mdr32/Boards/LDM-BB-K1986BE92QI-V1.03/README.md

# [LDM-BB-K1986BE92QI](https://ldm-systems.ru/product/19025) - Отладочная плата

Отладочная плата на микроконтроллере [K1986BE92QI](https://ic.milandr.ru/products/mikrokontrollery_i_protsessory/32_razryadnye_mikrokontrollery/k1986ve92qi) от компании [Milandr](https://milandr.ru/)
