mdr32/Boards/LDM-BB-K1986BE92QI-V1.03/img/LDM-BB-K1986BE92QI.png

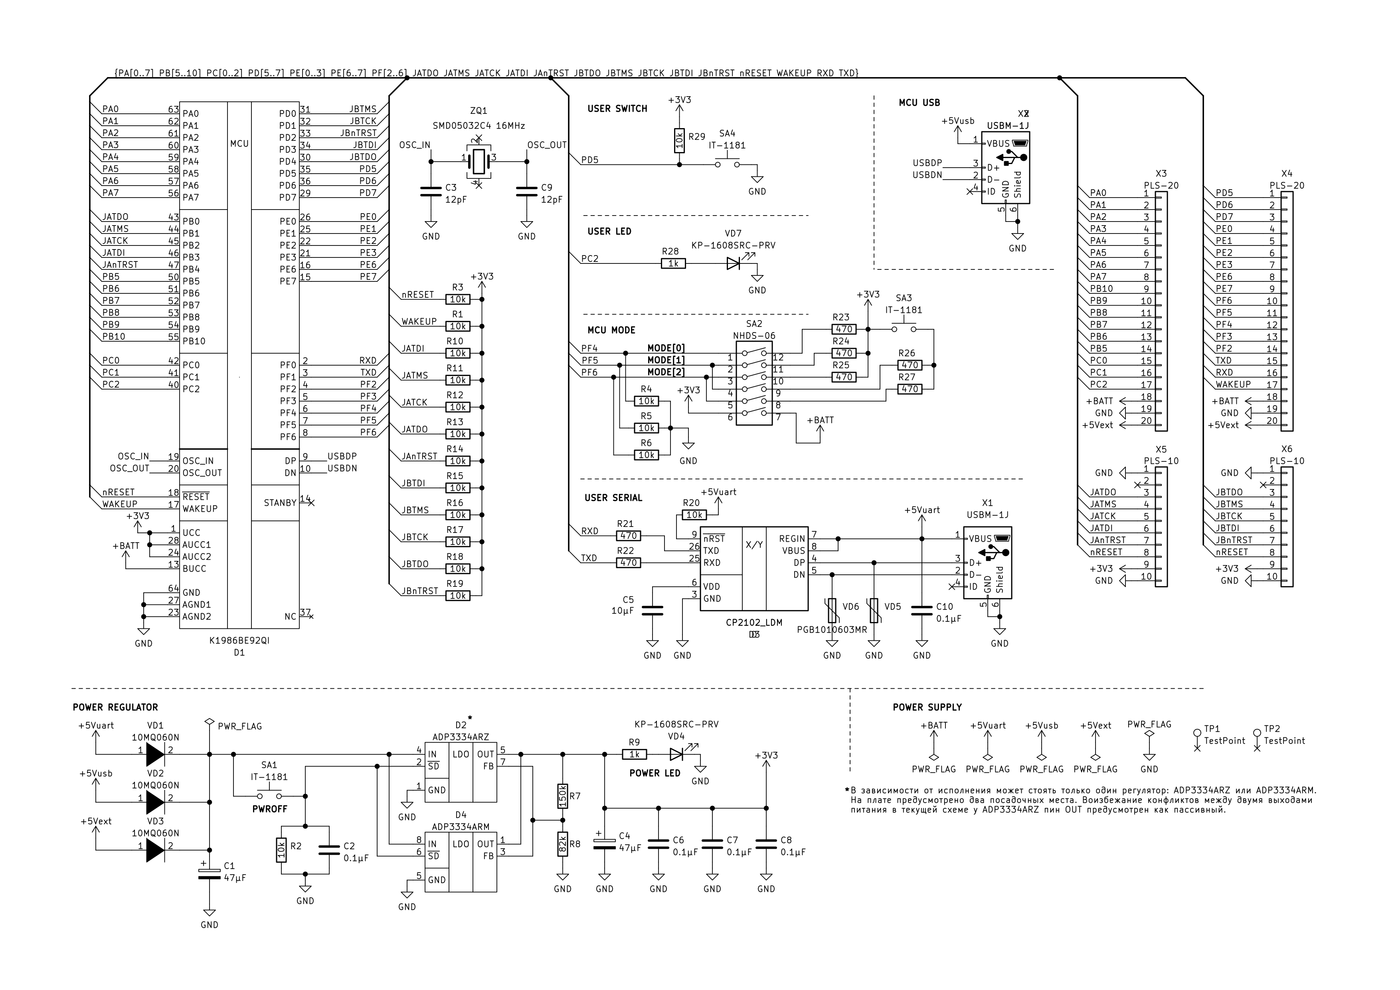
LDM-BB-K1986BE92QI-V1.03/img/LDM-BB-K1986BE92QI.png
