mdr32/Boards/LDM-BB-K1986BE92QI-V1.03/kicad_src/3dmodels/SW_SPST_CK_RS282G05A3.step

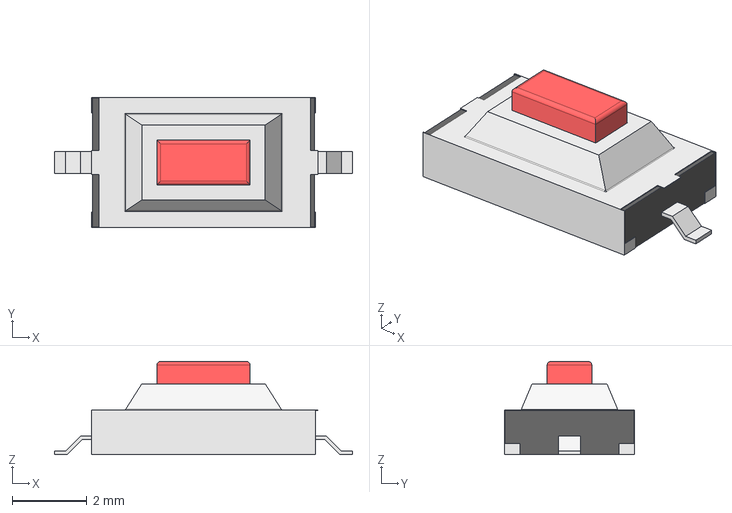
[picture p15: CAD file, 2022-06-08]
LDM-BB-K1986BE92QI-V1.03/kicad_src/3dmodels/SW_SPST_CK_RS282G05A3.step
8.00 x 3.50 x 2.50 mm
