mdr32/Boards/MDR32-K1986BE92FI-DK/kicad_src/3dmodels/LED_0805_2012Metric.step

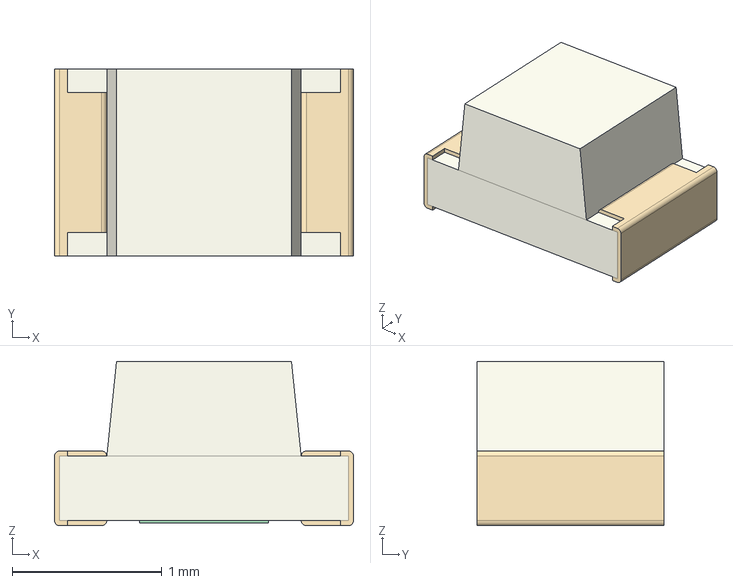
[picture p16: CAD file, 2025-02-06]
MDR32-K1986BE92FI-DK/kicad_src/3dmodels/LED_0805_2012Metric.step
2.00 x 1.25 x 1.10 mm
