mdr32/Boards/LDM-BB-K1986BE92QI-V1.03/kicad_src/3dmodels/LED_0603_1608Metric.step

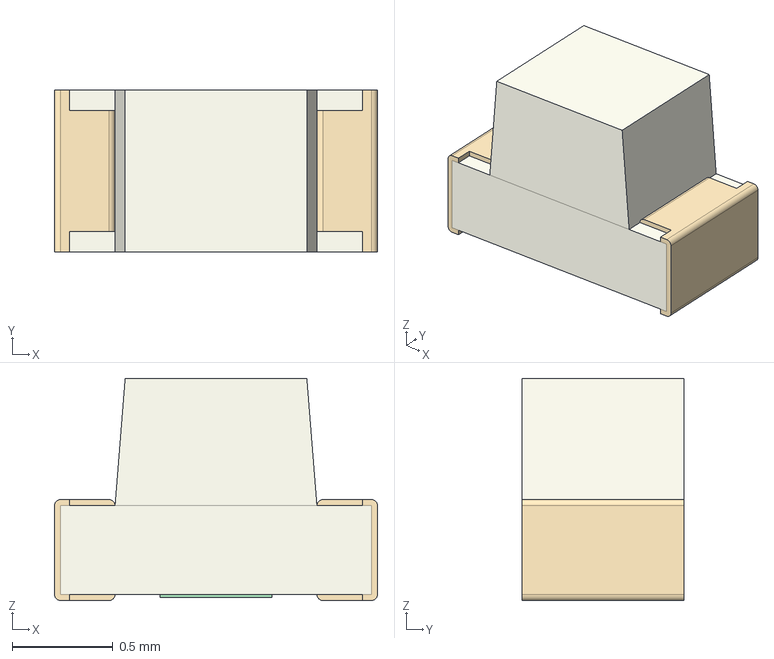
[picture p17: CAD file, 2022-06-08]
LDM-BB-K1986BE92QI-V1.03/kicad_src/3dmodels/LED_0603_1608Metric.step
1.60 x 0.8 x 1.10 mm
