mdr32/Boards/MDR32-K1986BE92FI-DK/kicad_src/3dmodels/Crystal_SMD_3225-4Pin_3.2x2.5mm.step

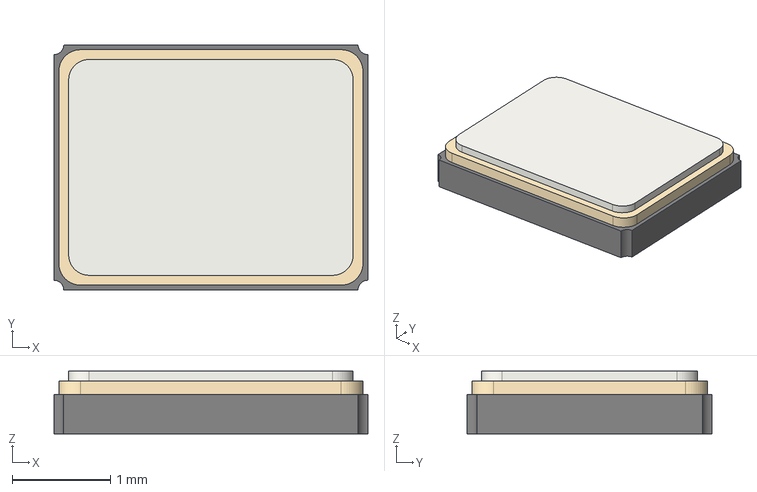
[picture p18: CAD file, 2025-02-06]
MDR32-K1986BE92FI-DK/kicad_src/3dmodels/Crystal_SMD_3225-4Pin_3.2x2.5mm.step
3.20 x 2.50 x 0.64 mm
