mdr32/Boards/LDM-BB-K1986BE92QI-V1.03/kicad_src/3dmodels/C_1206_3216Metric.step

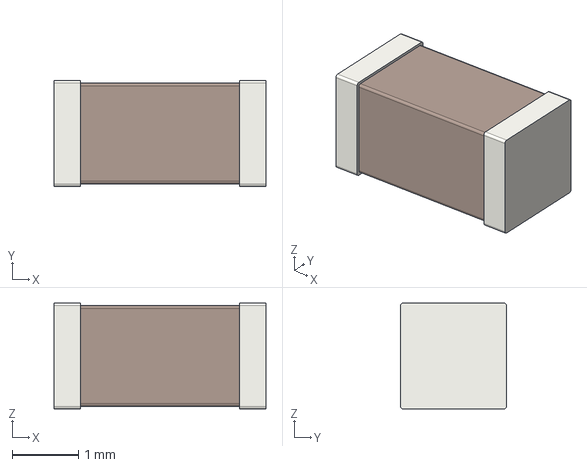
[picture p19: CAD file, 2022-06-08]
LDM-BB-K1986BE92QI-V1.03/kicad_src/3dmodels/C_1206_3216Metric.step
3.20 x 1.60 x 1.60 mm
