mdr32/Boards/MDR32-K1986BE92FI-DK/kicad_src/3dmodels/SOT-23.step

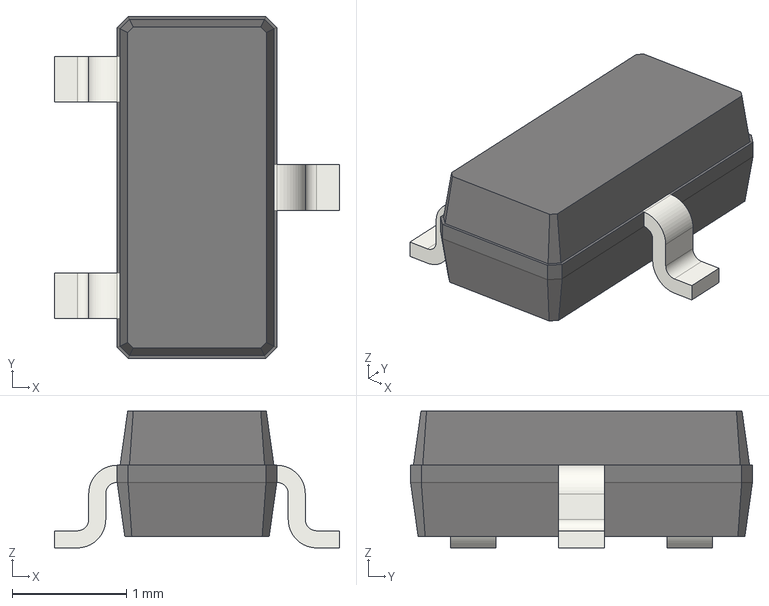
[picture p20: CAD file, 2025-02-06]
MDR32-K1986BE92FI-DK/kicad_src/3dmodels/SOT-23.step
2.50 x 3.00 x 1.20 mm
