mdr32/Boards/LDM-BB-K1986BE92QI-V1.03/kicad_src/3dmodels/R_0805_2012Metric.step

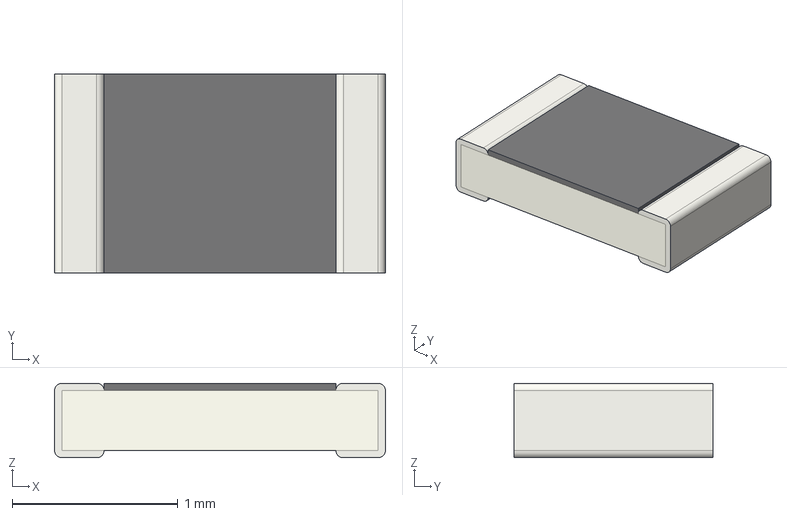
[picture p21: CAD file, 2022-06-08]
LDM-BB-K1986BE92QI-V1.03/kicad_src/3dmodels/R_0805_2012Metric.step
2.00 x 1.20 x 0.45 mm
