mdr32/Boards/MDR32-K1986BE92FI-DK/kicad_src/3dmodels/SOT-223.step

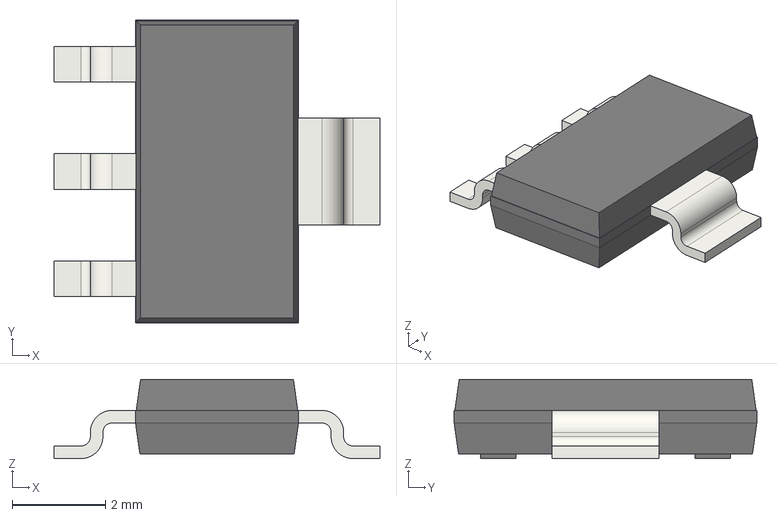
[picture p22: CAD file, 2025-02-06]
MDR32-K1986BE92FI-DK/kicad_src/3dmodels/SOT-223.step
7.00 x 6.50 x 1.70 mm
