mdr32/Boards/LDM-BB-K1986BE92QI-V1.03/kicad_src/3dmodels/DO-214AC.step

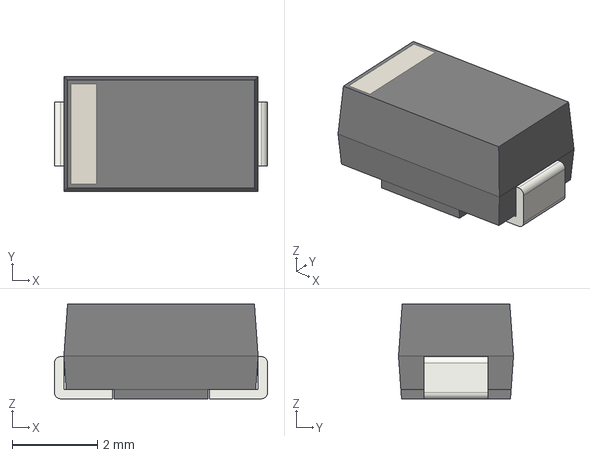
[picture p23: CAD file, 2022-06-08]
LDM-BB-K1986BE92QI-V1.03/kicad_src/3dmodels/DO-214AC.step
5.00 x 2.70 x 2.22 mm
