mdr32/Boards/MDR32-K1986BE92FI-DK/kicad_src/3dmodels/PinHeader_1x04_P2.54mm_Horizontal.step

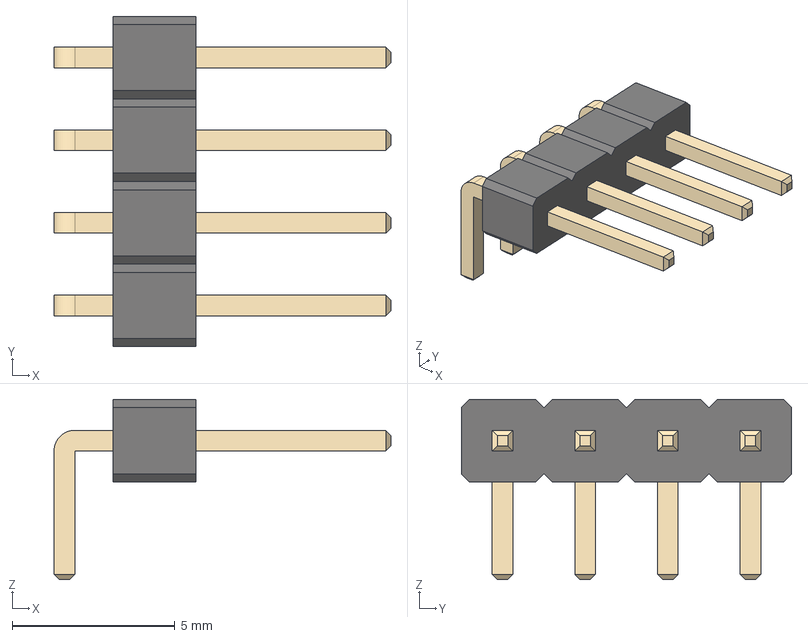
[picture p24: CAD file, 2025-02-06]
MDR32-K1986BE92FI-DK/kicad_src/3dmodels/PinHeader_1x04_P2.54mm_Horizontal.step
10.4 x 10.2 x 5.54 mm
