mdr32/Boards/LDM-BB-K1986BE92QI-V1.03/kicad_src/3dmodels/LQFP-64_10x10mm_P0.5mm.step

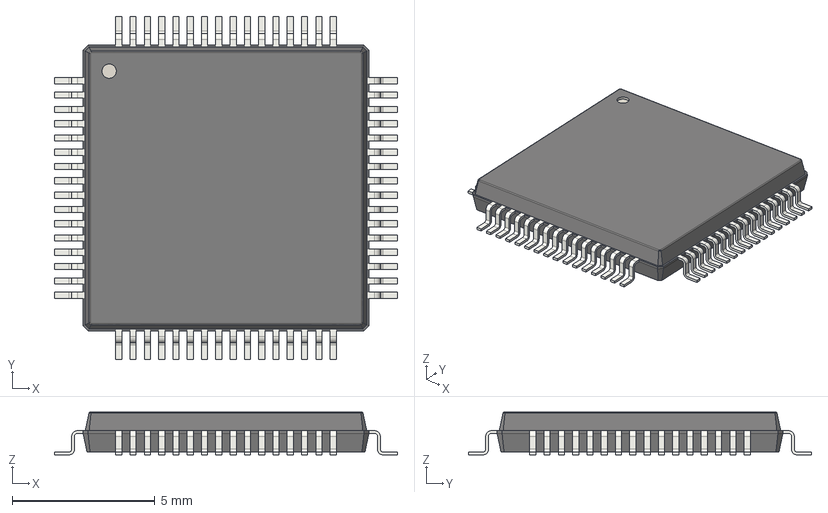
[picture p25: CAD file, 2022-06-08]
LDM-BB-K1986BE92QI-V1.03/kicad_src/3dmodels/LQFP-64_10x10mm_P0.5mm.step
12.0 x 12.0 x 1.50 mm
