mdr32/Boards/MDR32-K1986BE92FI-DK/kicad_src/3dmodels/QFN-64-1EP_9x9mm_P0.5mm_EP7.5x7.5mm.step

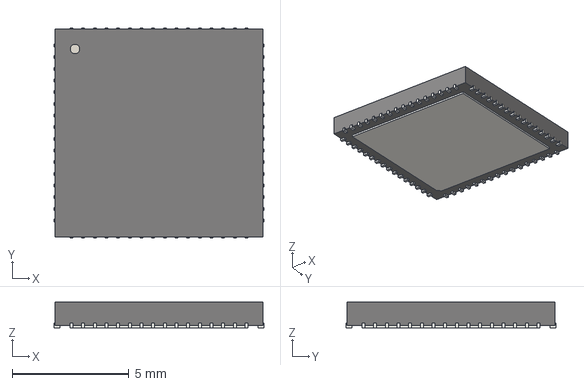
[picture p26: CAD file, 2025-02-06]
MDR32-K1986BE92FI-DK/kicad_src/3dmodels/QFN-64-1EP_9x9mm_P0.5mm_EP7.5x7.5mm.step
9.00 x 9.00 x 1.10 mm
