mdr32/Boards/LDM-BB-K1986BE92QI-V1.03/kicad_src/3dmodels/MSOP-8_3x3mm_P0.65mm.step

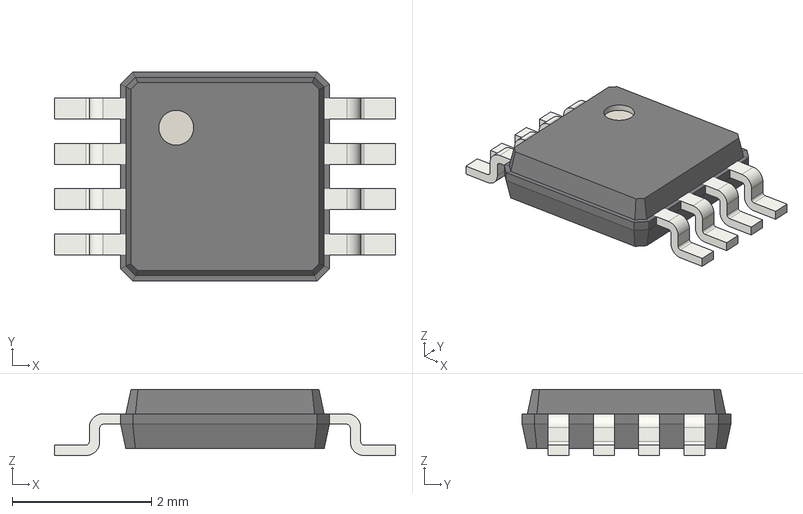
[picture p27: CAD file, 2022-06-08]
LDM-BB-K1986BE92QI-V1.03/kicad_src/3dmodels/MSOP-8_3x3mm_P0.65mm.step
4.90 x 3.00 x 0.95 mm
