mdr32/Boards/MDR32-K1986BE92FI-DK/kicad_src/3dmodels/USB_C_Receptacle_GCT_USB4105-xx-A_16P_TopMnt_Horizontal.step

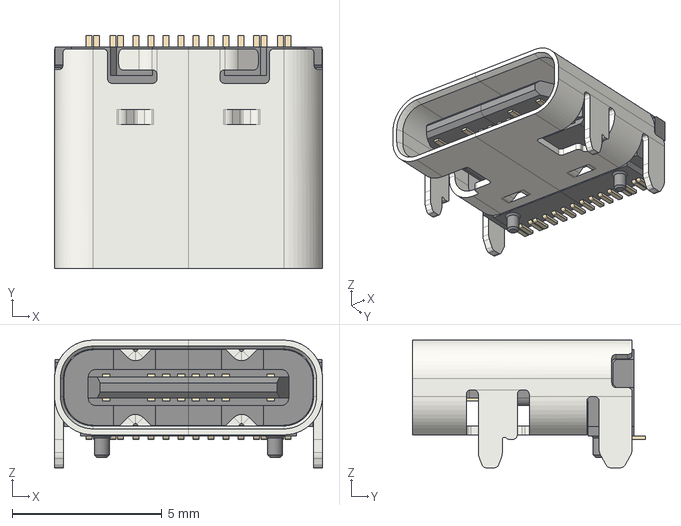
[picture p28: CAD file, 2025-02-06]
MDR32-K1986BE92FI-DK/kicad_src/3dmodels/USB_C_Receptacle_GCT_USB4105-xx-A_16P_TopMnt_Horizontal.step
8.94 x 7.78 x 4.26 mm
