mdr32/Boards/LDM-BB-K1986BE92QI-V1.03/kicad_src/3dmodels/5032_XTAL.step

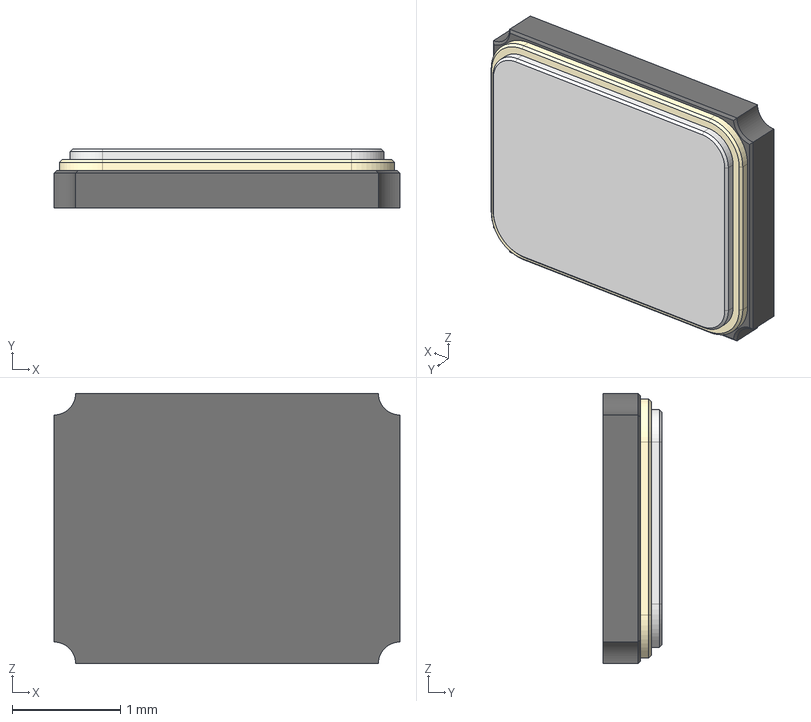
[picture p29: CAD file, 2022-06-08]
LDM-BB-K1986BE92QI-V1.03/kicad_src/3dmodels/5032_XTAL.step
3.20 x 0.55 x 2.50 mm
