mdr32/Boards/MDR32-K1986BE92FI-DK/kicad_src/3dmodels/PinHeader_1x16_P2.54mm_Vertical.step

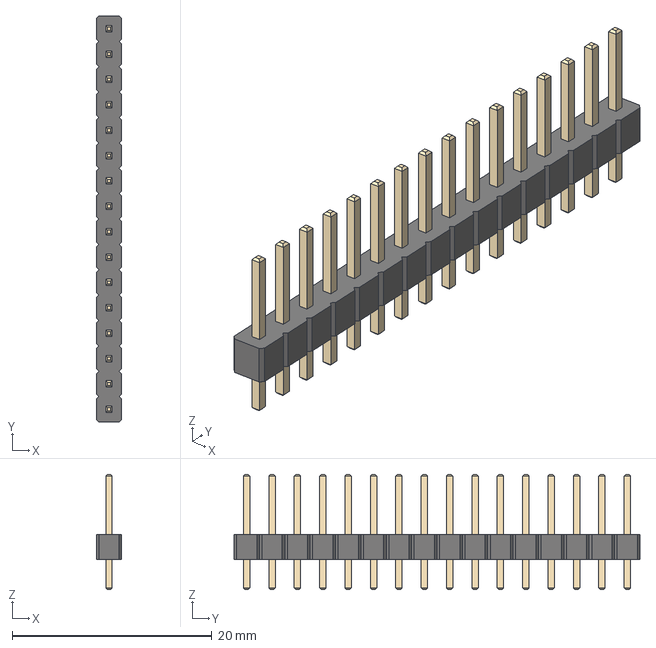
[picture p30: CAD file, 2025-02-06]
MDR32-K1986BE92FI-DK/kicad_src/3dmodels/PinHeader_1x16_P2.54mm_Vertical.step
2.54 x 40.6 x 11.5 mm
