mdr32/Boards/LDM-BB-K1986BE92QI-V1.03/kicad_src/3dmodels/CP_EIA-3528-21_Kemet-B.step

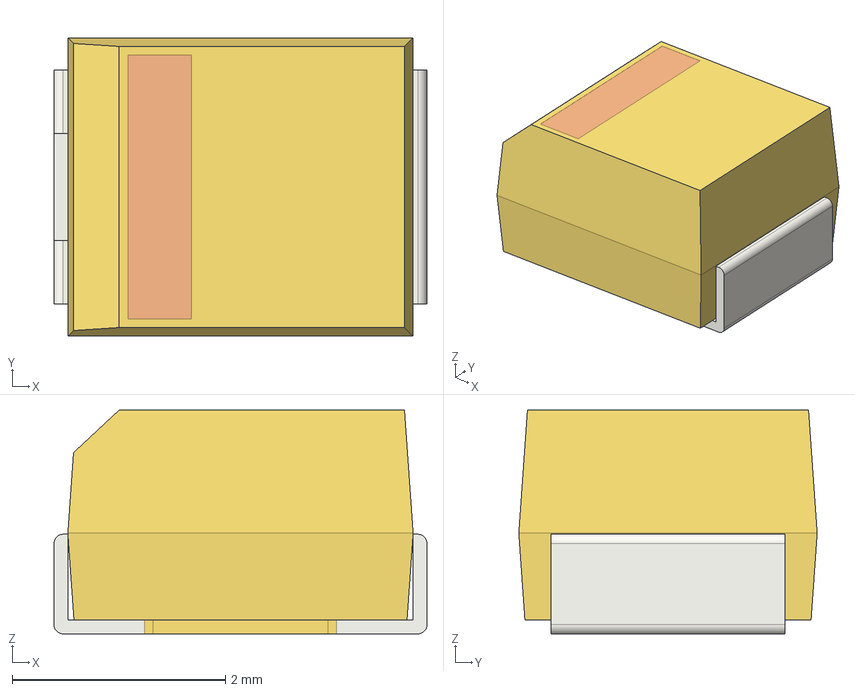
[picture p31: CAD file, 2022-06-08]
LDM-BB-K1986BE92QI-V1.03/kicad_src/3dmodels/CP_EIA-3528-21_Kemet-B.step
3.50 x 2.80 x 2.10 mm
