mdr32/Boards/MDR32-K1986BE92FI-DK/kicad_src/3dmodels/CP_EIA-3216-18_Kemet-A.step

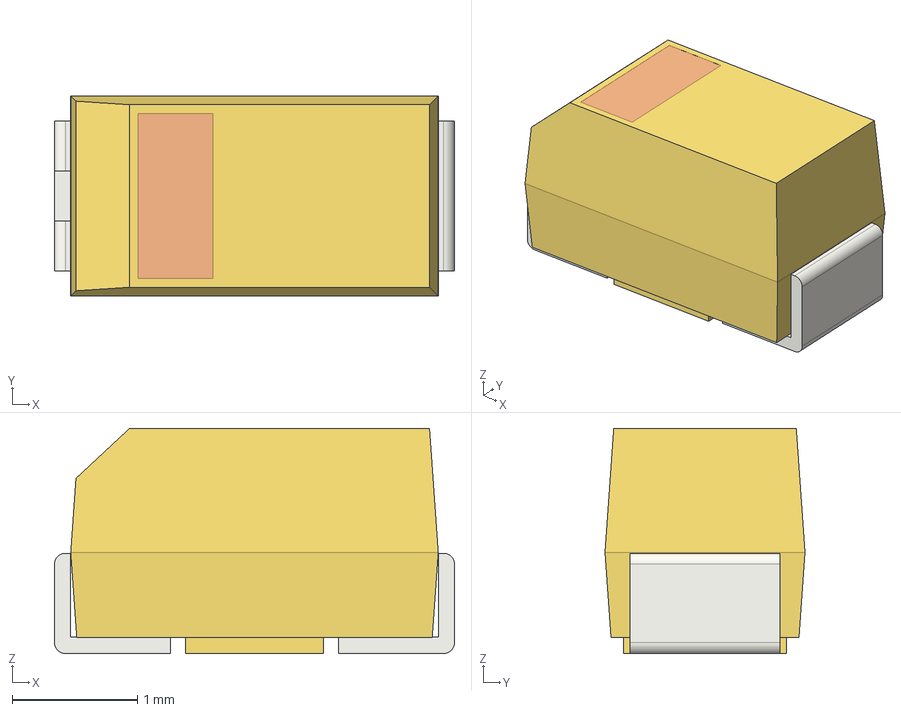
[picture p32: CAD file, 2025-02-06]
MDR32-K1986BE92FI-DK/kicad_src/3dmodels/CP_EIA-3216-18_Kemet-A.step
3.20 x 1.60 x 1.80 mm
