mdr32/Boards/LDM-BB-K1986BE92QI-V1.03/kicad_src/3dmodels/USB_Mini-B_Lumberg_2486_01_Horizontal.step

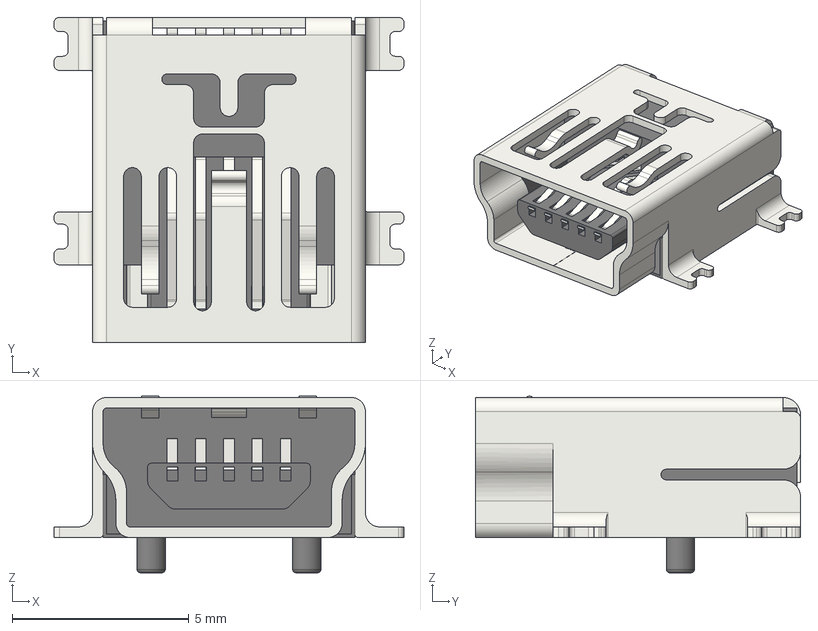
[picture p33: CAD file, 2022-06-08]
LDM-BB-K1986BE92QI-V1.03/kicad_src/3dmodels/USB_Mini-B_Lumberg_2486_01_Horizontal.step
9.90 x 9.20 x 5.00 mm
