mdr32/Boards/MDR32-K1986BE92FI-DK/kicad_src/3dmodels/SW_DIP_SPSTx02_Slide_Omron_A6H-2101_W6.15mm_P1.27mm.step

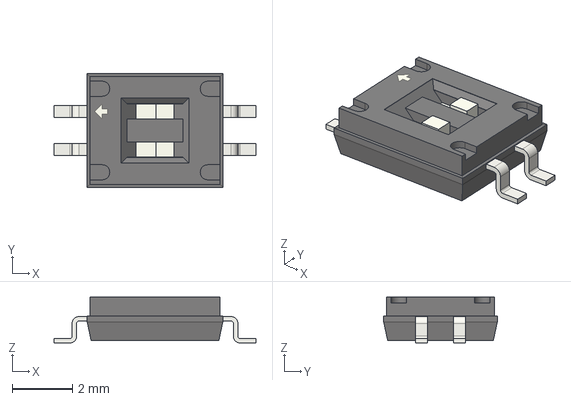
[picture p34: CAD file, 2025-02-06]
MDR32-K1986BE92FI-DK/kicad_src/3dmodels/SW_DIP_SPSTx02_Slide_Omron_A6H-2101_W6.15mm_P1.27mm.step
6.70 x 3.77 x 1.53 mm
