mdr32/Boards/LDM-BB-K1986BE92QI-V1.03/kicad_src/3dmodels/QFN-28-1EP_5x5mm_P0.5mm_EP3.35x3.35mm.step

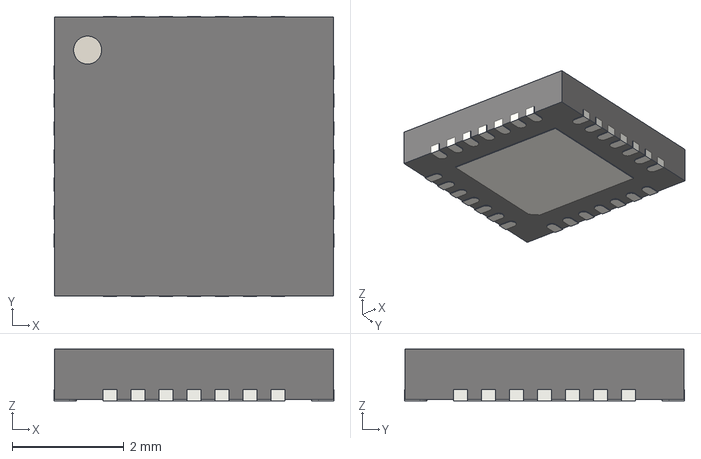
[picture p35: CAD file, 2022-06-08]
LDM-BB-K1986BE92QI-V1.03/kicad_src/3dmodels/QFN-28-1EP_5x5mm_P0.5mm_EP3.35x3.35mm.step
5.00 x 5.00 x 0.92 mm
