mdr32/Boards/MDR32-K1986BE92FI-DK/kicad_src/3dmodels/SW_SPST_B3U-1000P.step

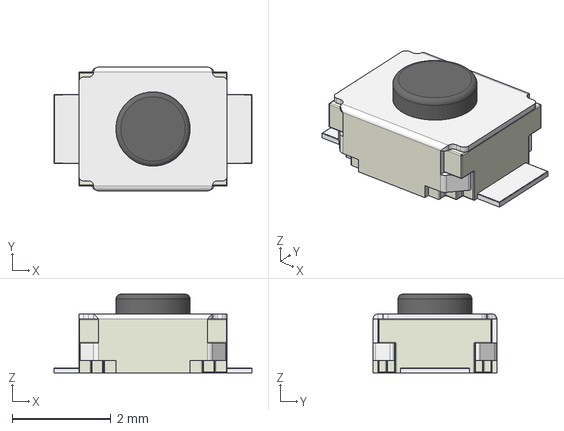
[picture p36: CAD file, 2025-02-06]
MDR32-K1986BE92FI-DK/kicad_src/3dmodels/SW_SPST_B3U-1000P.step
4.00 x 2.50 x 1.59 mm
