mdr32/Boards/LDM-BB-K1986BE92QI-V1.03/kicad_src/3dmodels/PinHeader_1x20_P2.54mm_Vertical.step

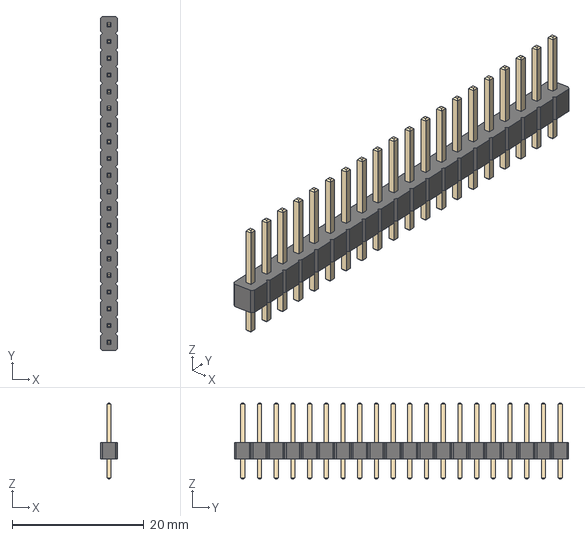
[picture p37: CAD file, 2022-06-08]
LDM-BB-K1986BE92QI-V1.03/kicad_src/3dmodels/PinHeader_1x20_P2.54mm_Vertical.step
2.54 x 50.8 x 11.5 mm
