mdr32/Boards/MDR32-K1986BE92FI-DK/kicad_src/3dmodels/D_SOD-123.step

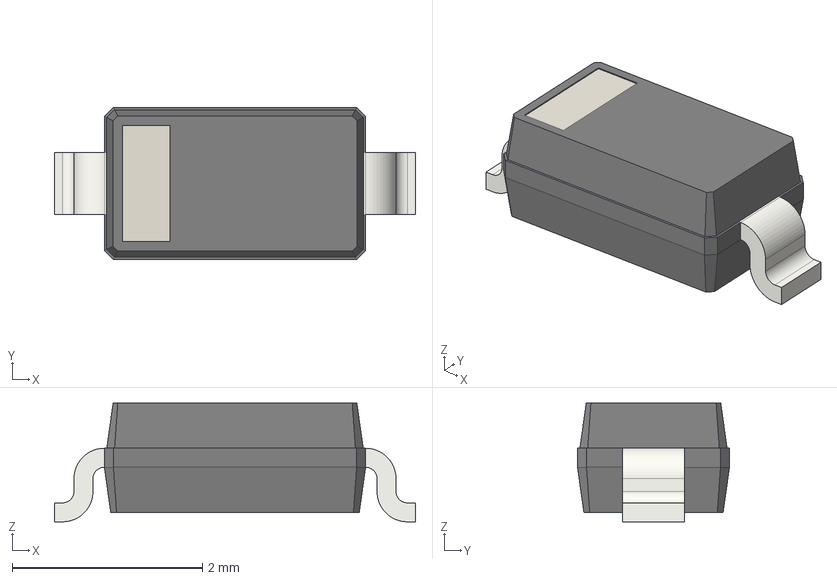
[picture p38: CAD file, 2025-02-06]
MDR32-K1986BE92FI-DK/kicad_src/3dmodels/D_SOD-123.step
3.80 x 1.60 x 1.25 mm
