mdr32/Boards/LDM-BB-K1986BE92QI-V1.03/kicad_src/3dmodels/SW_DIP_SPSTx06_Slide_Omron_A6H-6101_W6.15mm_P1.27mm.step

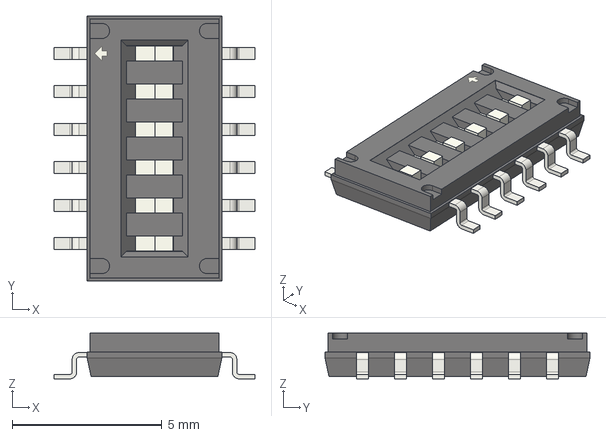
[picture p39: CAD file, 2022-06-08]
LDM-BB-K1986BE92QI-V1.03/kicad_src/3dmodels/SW_DIP_SPSTx06_Slide_Omron_A6H-6101_W6.15mm_P1.27mm.step
6.70 x 8.85 x 1.53 mm
