mdr32/Boards/MDR32-K1986BE92FI-DK/kicad_src/3dmodels/Crystal_SMD_3215-2Pin_3.2x1.5mm.step

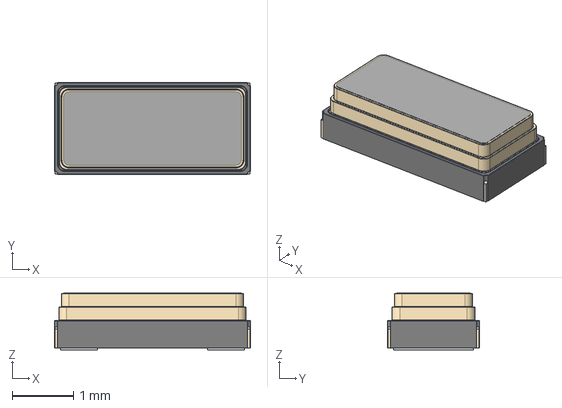
[picture p40: CAD file, 2025-02-06]
MDR32-K1986BE92FI-DK/kicad_src/3dmodels/Crystal_SMD_3215-2Pin_3.2x1.5mm.step
3.20 x 1.50 x 0.93 mm
