mdr32/Boards/LDM-BB-K1986BE92QI-V1.03/kicad_src/3dmodels/SOIC-8_3.9x4.9mm_P1.27mm.step

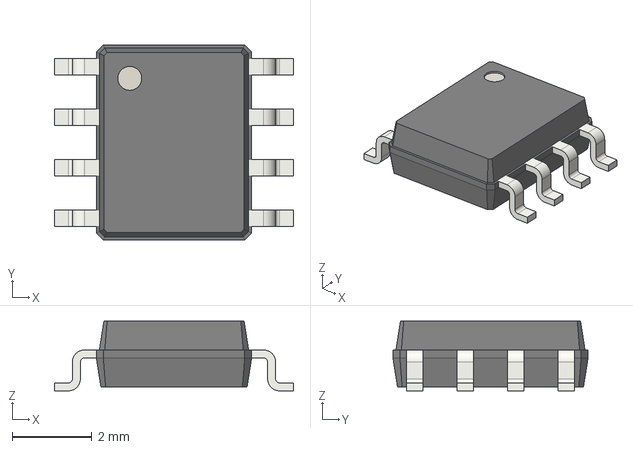
[picture p41: CAD file, 2022-06-08]
LDM-BB-K1986BE92QI-V1.03/kicad_src/3dmodels/SOIC-8_3.9x4.9mm_P1.27mm.step
6.00 x 4.90 x 1.75 mm
