mdr32/Boards/MDR32-K1986BE92FI-DK/kicad_src/3dmodels/C_0603_1608Metric.step

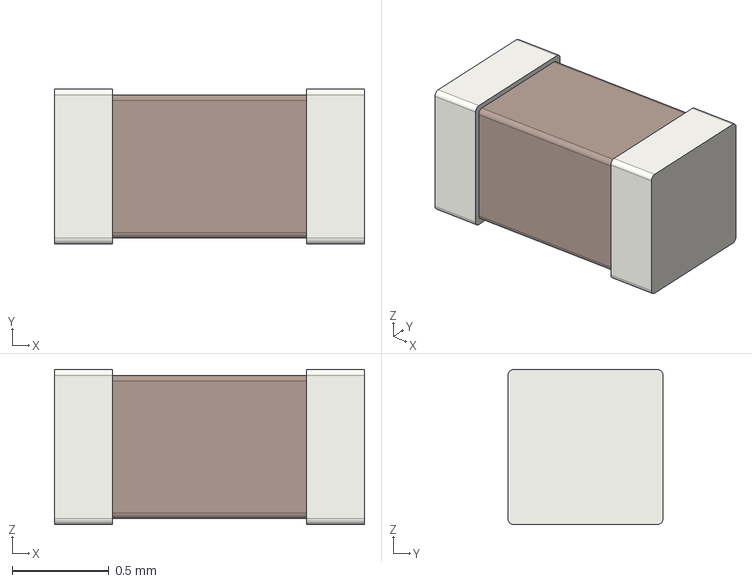
[picture p43: CAD file, 2022-06-08]
MDR32-K1986BE92FI-DK/kicad_src/3dmodels/C_0603_1608Metric.step
1.60 x 0.8 x 0.8 mm
