mdr32/Boards/MDR32-K1986BE92FI-DK/kicad_src/3dmodels/PinHeader_1x10_P2.54mm_Vertical.step

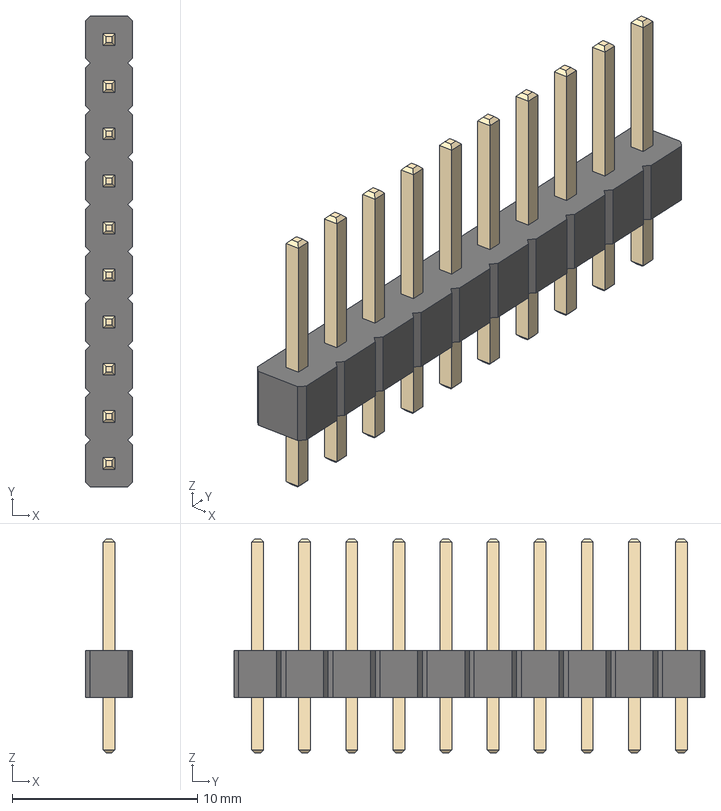
[picture p45: CAD file, 2022-06-08]
MDR32-K1986BE92FI-DK/kicad_src/3dmodels/PinHeader_1x10_P2.54mm_Vertical.step
2.54 x 25.4 x 11.5 mm
