mdr32/Boards/(list of files, cad)

Other CAD files:
MDR32-K1986BE92FI-DK/kicad_src/3dmodels/R_0603_1608Metric.step
