mdr32/Boards/MDR32-K1986BE92FI-DK/sch_MDR32-K1986BE92FI-DK.pdf

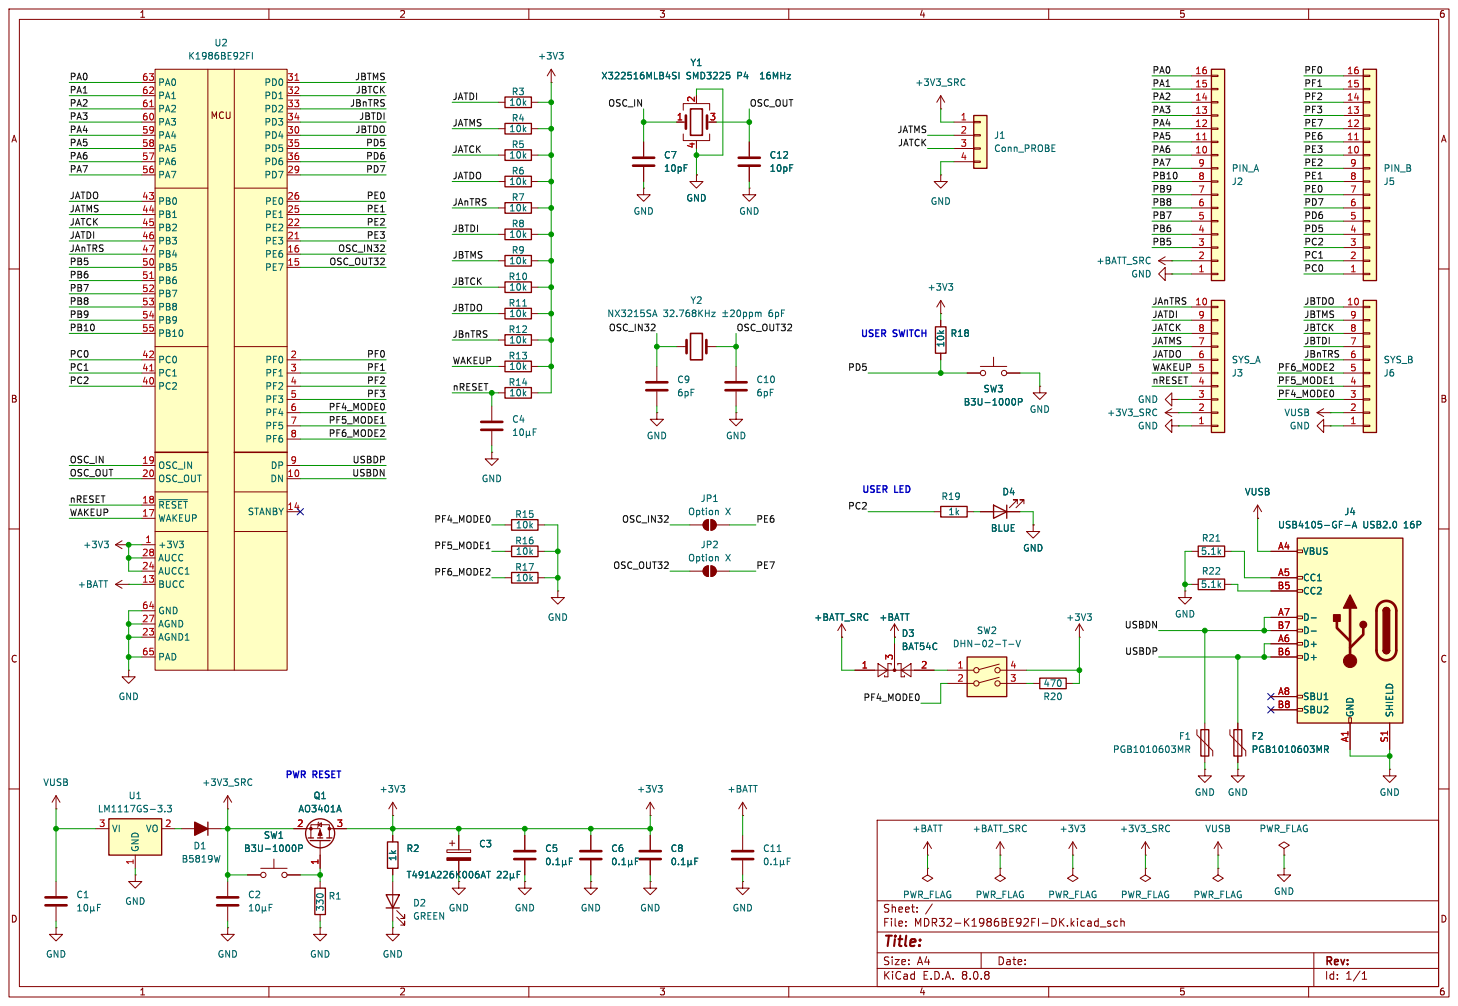
[picture p46: page 1]

Id: 1/1 Title: File: MDR32-K1986BE92FI-DK.kicad_sch Sheet: / C1
