mdr32/Boards/MDR32-K1986BE92FI-KeyBrain/kicad_src/MDR32-K1986BE92FI-KeyBrain.kicad_pcb

## KiCad design MDR32-K1986BE92FI-KeyBrain/kicad_src/MDR32-K1986BE92FI-KeyBrain.kicad_pcb (2026-06-09)

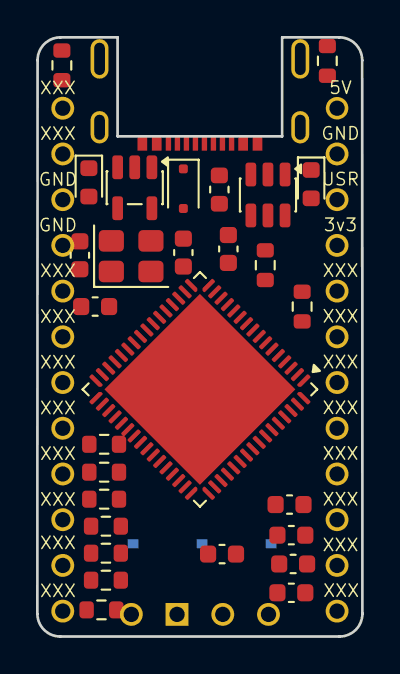
[picture p47: board MDR32-K1986BE92FI-KeyBrain.kicad_pcb from above]

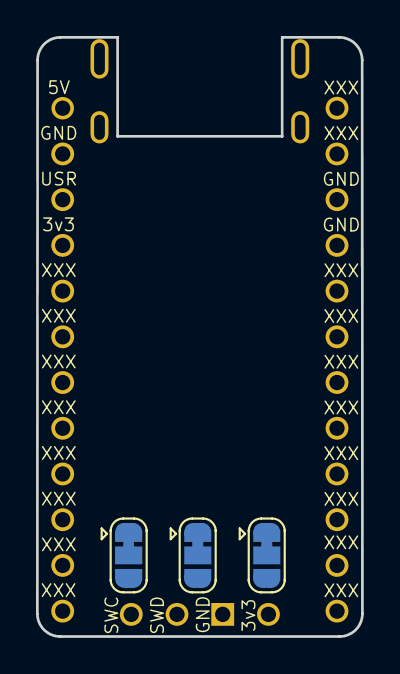
[picture p48: board MDR32-K1986BE92FI-KeyBrain.kicad_pcb from below]

Board: 2 copper layers, 18.1 x 33.3 mm, 34 parts (3 on the bottom side), 45 nets, no tracks yet.

Parts:
C1: 1μF; C_0603_1608Metric
C2, C5, C12: 10pF; C_0603_1608Metric
C3: 10μF; C_0603_1608Metric
C4, C6, C7, C8: 0.1μF; C_0603_1608Metric
D1: 3A/10V/280mV; D_SOD-323F
D2: RED; LED_0603_1608Metric
D3: GREEN; LED_0603_1608Metric
F1: 6V 0.5A MF-FSMF050X-2; Fuse_0603_1608Metric
J1: USB-C USB 2.0 MC-372; USB-C_C168688
J2: Conn_01x04; connector_swd
JP1: MODE0; SolderJumper-3_P1.3mm_Bridged12_RoundedPad1.0x1.5mm
JP2: MODE1; SolderJumper-3_P1.3mm_Bridged12_RoundedPad1.0x1.5mm
JP3: MODE2; SolderJumper-3_P1.3mm_Bridged12_RoundedPad1.0x1.5mm
R1, R2, R3, R4, R5, R6, R7: 10K; R_0603_1608Metric
R8, R9: 5.1K; R_0603_1608Metric
R10, R11: 1K; R_0603_1608Metric
U1: AP2112K-3.3; SOT-23-5
U2: USBLC6-2SC6; SOT-23-6
U3: K1986BE92FI; QFN-64-1EP_9x9mm_P0.5mm_EP7.5x7.5mm
U4: ProMicro; pro_micro
Y1: 8MHz; Crystal_SMD_3225-4Pin_3.2x2.5mm

Connections:
+3.3V: C3.1, C6.1, C7.1, C8.1, J2.1, JP1.1 (A), JP2.3 (B), JP3.3 (B), R1.2, R2.2, R3.2, R4.2, R5.2, R6.2, R7.2, R10.2, U1.5 (VOUT), U3.1 (UCC), U3.12 (UCC), U3.13 (BUCC), U3.24 (AUCC1), U3.28 (AUCC), U3.38 (UCC), U3.48 (UCC), U4.4 (VCC)
+5V: D1.1 (K), U1.1 (VIN), U1.3 (EN), U4.1 (RAW)
/0/TX0: U3.56 (PA7), U4.13 (PD3)
/1/RX0: U3.57 (PA6), U4.14 (PD2)
/2/SDA: U3.41 (PC1), U4.17 (PD1)
/3/SCL: U3.42 (PC0), U4.18 (PD0)
/4: U3.29 (PD7), U4.19 (PD4)
/5: U3.58 (PA5), U4.20 (PC6)
/6: U3.36 (PD6), U4.21 (PD7)
/7: U3.63 (PA0), U4.22 (PE6)
/8/TX1: U3.32 (PD1), U4.23 (PB4)
/9/RX1: U3.31 (PD0), U4.24 (PB5)
/20/SPI_CIPO: U3.5 (PF3), U4.10 (PB3)
/21/SPI_~CS: U3.4 (PF2), U4.12 (PB6)
/22/SPI_SCK: U3.3 (PF1), U4.9 (PB1)
/23/SPI_COPI: U3.2 (PF0), U4.11 (PB2)
/A0: U3.33 (PD2), U4.8 (PF7)
/A1: U3.34 (PD3), U4.7 (PF6)
/A2: U3.30 (PD4), U4.6 (PF5)
/A3: U3.35 (PD5), U4.5 (PF4)
/CLK: J2.3, R2.1, U3.45 (PB2)
/D+: J1.A6 (D+), J1.B6 (D+), U2.3 (I/O2)
/D-: J1.A7 (D-), J1.B7 (D-), U2.1 (I/O1)
/DATA+: U2.4 (I/O2), U3.9 (DP)
/DATA-: U2.6 (I/O1), U3.10 (DN)
/DIO: J2.2, R1.1, U3.44 (PB1)
/JATDI: R4.1, U3.46 (PB3)
/JATDO: R5.1, U3.43 (PB0)
/JAnTRS: R3.1, U3.47 (PB4)
/JTAG_MODE1: JP1.2 (C), U3.6 (PF4)
/JTAG_MODE2: JP2.2 (C), U3.7 (PF5)
/JTAG_MODE3: JP3.2 (C), U3.8 (PF6)
/OSC_IN: C2.1, U3.19 (OSC_IN), Y1.1
/OSC_OUT: C5.1, C12.1, U3.20 (OSC_OUT), Y1.3
/USRBTN: U3.62 (PA1), U4.3 (RST)
/USRLED: R11.2, U3.59 (PA4)
/WAKEUP: R7.1, U3.17 (WAKEUP)
/nRESET: R6.1, U3.18 (~RESET)
GND: C1.2, C2.2, C3.2, C4.2, C5.2, C6.2, C7.2, C8.2, C12.2, D2.1 (K), D3.1 (K), J1.A1 (GND), J2.4, JP1.3 (B), JP2.1 (A), JP3.1 (A), R8.2, R9.2, U1.2 (GND), U2.2 (GND), U3.11 (GND), U3.23 (AGND1), U3.27 (AGND), U3.39 (GND), U3.49 (GND), U3.64 (GND), U3.65 (PAD), U4.2 (GND), U4.15 (GND), U4.16 (GND), Y1.2, Y1.4
unnamed: D1.2 (A), F1.2
unnamed: D2.2 (A), R10.1
unnamed: D3.2 (A), R11.1
unnamed: J1.A5 (CC1), R9.1
unnamed: J1.B5 (CC2), R8.1
VBUS: C1.1, C4.1, F1.1, J1.A4 (VBUS), U2.5 (VBUS)
