mdr32/Boards/MDR32-K1986BE92FI-DK/kicad_src/MDR32-K1986BE92FI-DK.kicad_pcb

## KiCad design MDR32-K1986BE92FI-DK/kicad_src/MDR32-K1986BE92FI-DK.kicad_pcb (2025-02-06)

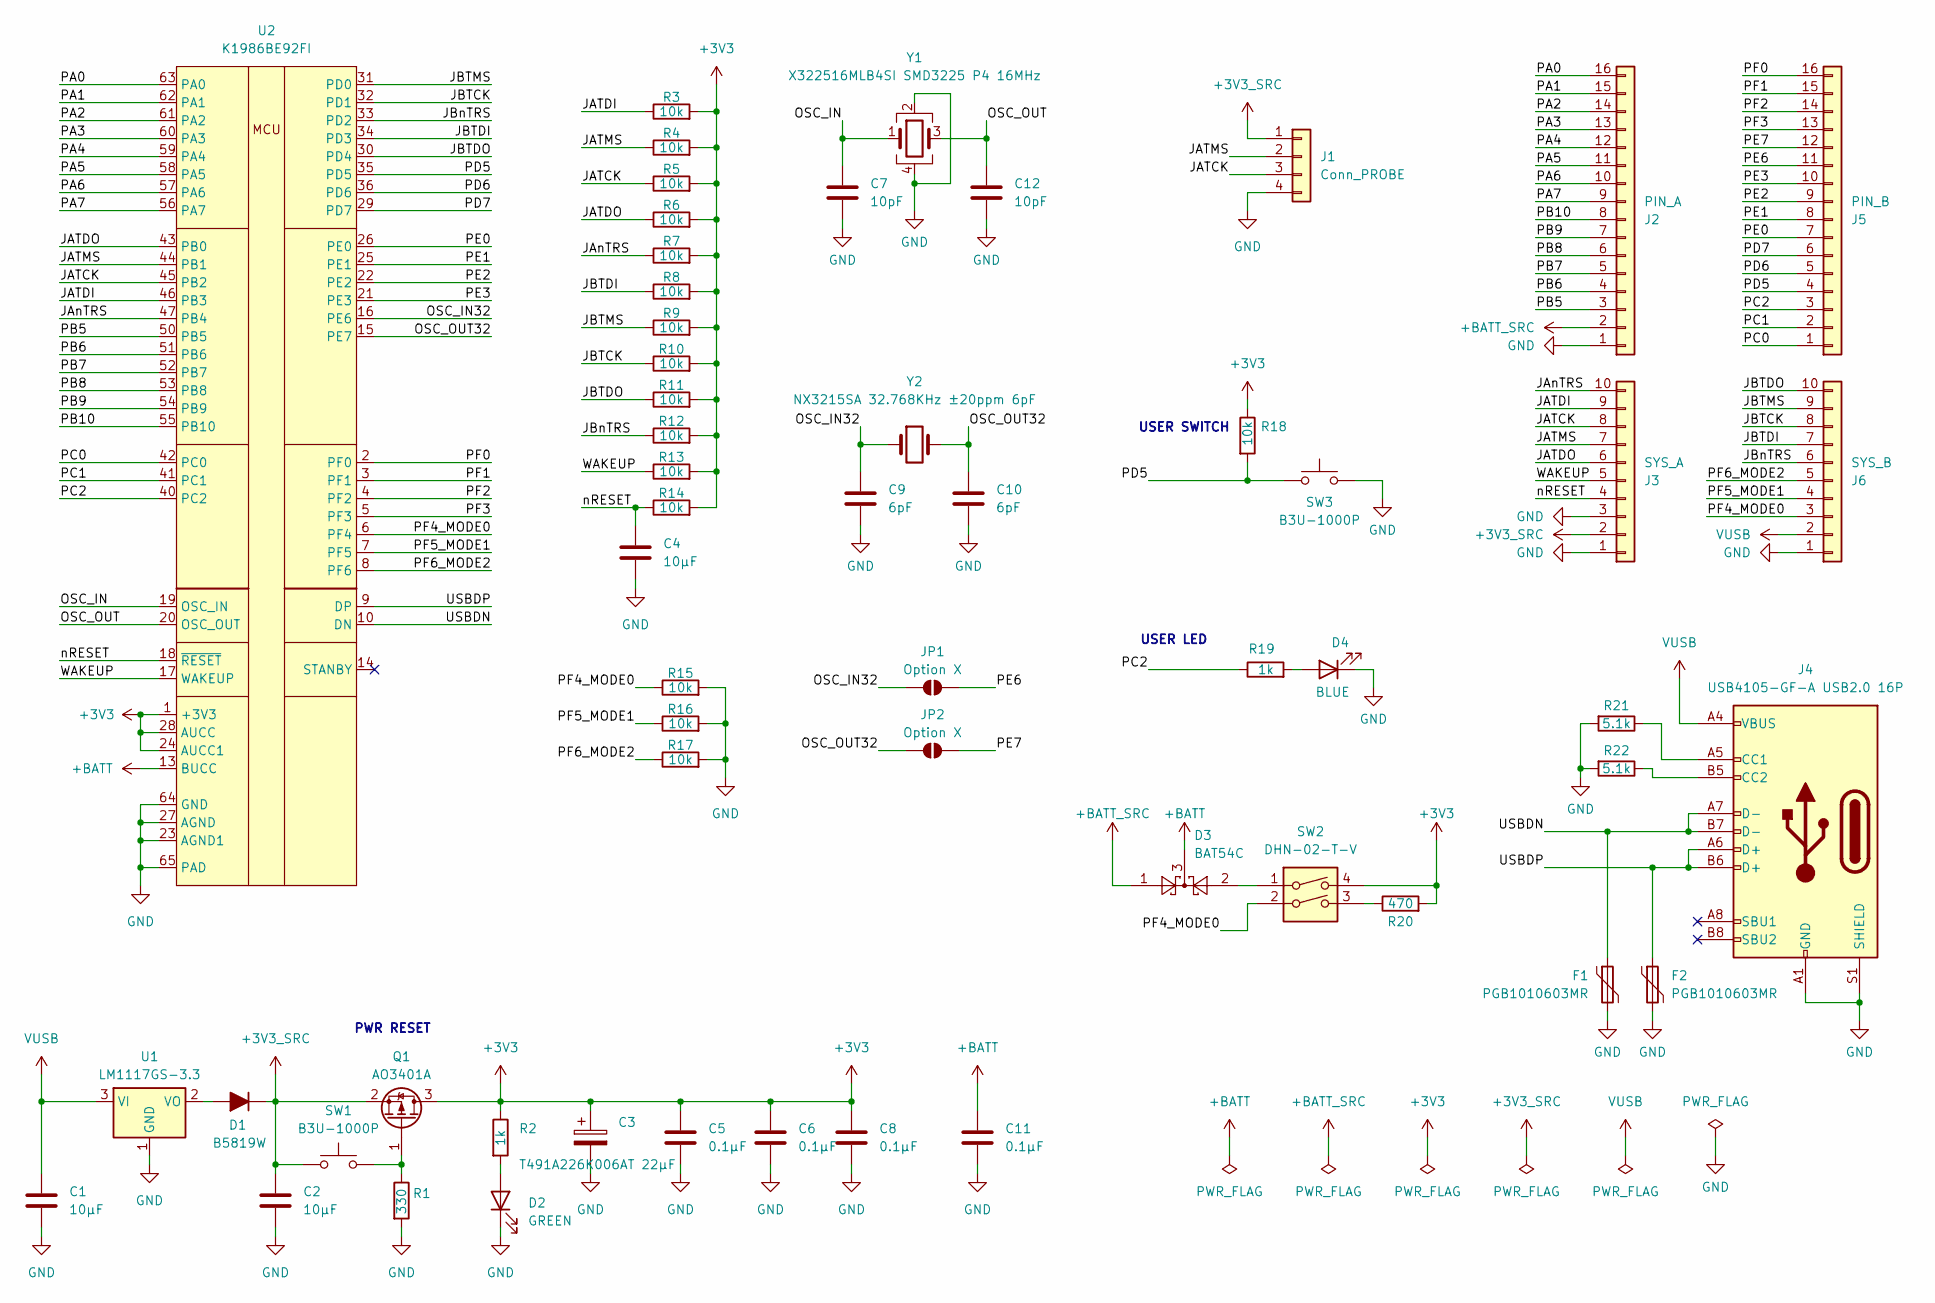
[picture p49: schematic MDR32-K1986BE92FI-DK.kicad_sch]

Parts:
C1, C2: 10µF; C_0805_2012Metric
C3: T491A226K006AT 22µF; CP_EIA-3216-18_Kemet-A
C4: 10µF; C_0603_1608Metric
C5, C6, C8, C11: 0.1µF; C_0603_1608Metric
C7, C12: 10pF; C_0603_1608Metric
C9, C10: 6pF; C_0603_1608Metric
D1: B5819W; D_SOD-123
D2: GREEN; LED_0805_2012Metric
D3: BAT54C; SOT-23
D4: BLUE; LED_0805_2012Metric
F1, F2: PGB1010603MR; Fuse_0603_1608Metric
J1: Conn_PROBE; PinHeader_1x04_P2.54mm_Horizontal
J2: PIN_A; PinHeader_1x16_P2.54mm_Vertical
J3: SYS_A; PinHeader_1x10_P2.54mm_Vertical
J4: USB4105-GF-A USB2.0 16P; USB_C_Receptacle_GCT_USB4105-xx-A_16P_TopMnt_Horizontal
J5: PIN_B; PinHeader_1x16_P2.54mm_Vertical
J6: SYS_B; PinHeader_1x10_P2.54mm_Vertical
JP1, JP2: Option X; SolderJumper-2_P1.3mm_Open_TrianglePad1.0x1.5mm
Q1: AO3401A; SOT-23
R1: 330; R_0603_1608Metric
R2, R19: 1k; R_0603_1608Metric
R3, R4, R5, R6, R7, R8, R9, R10, R11, R12, R13, R14, R15, R16, R17, R18: 10k; R_0603_1608Metric
R20: 470; R_0603_1608Metric
R21, R22: 5.1k; R_0603_1608Metric
SW1, SW3: B3U-1000P; SW_SPST_B3U-1000P
SW2: DHN-02-T-V; SW_DIP_SPSTx02_Slide_Omron_A6H-2101_W6.15mm_P1.27mm
U1: LM1117GS-3.3; SOT-223
U2: K1986BE92FI; QFN-64-1EP_9x9mm_P0.5mm_EP7.5x7.5mm
Y1: X322516MLB4SI SMD3225 P4 16MHz; Crystal_SMD_3225-4Pin_3.2x2.5mm
Y2: NX3215SA 32.768KHz ±20ppm 6pF; Crystal_SMD_3215-2Pin_3.2x1.5mm

Connections:
+3V3: C3.1, C5.1, C6.1, C8.1, Q1.3 (D), R2.1, R3.2, R4.2, R5.2, R6.2, R7.2, R8.2, R9.2, R10.2, R11.2, R12.2, R13.2, R14.2, R18.1, R20.2, SW2.4, U2.1 (+3V3), U2.24 (AUCC1), U2.28 (AUCC)
+3V3_SRC: C2.1, D1.1 (K), J1.1, J3.2, Q1.2 (S), SW1.1
+BATT: C11.1, D3.3, U2.13 (BUCC)
+BATT_SRC: D3.1, J2.2
/JATCK: J1.3, J3.8, R5.1, U2.45 (PB2)
/JATDI: J3.9, R3.1, U2.46 (PB3)
/JATDO: J3.6, R6.1, U2.43 (PB0)
/JATMS: J1.2, J3.7, R4.1, U2.44 (PB1)
/JAnTRS: J3.10, R7.1, U2.47 (PB4)
/JBTCK: J6.8, R10.1, U2.32 (PD1)
/JBTDI: J6.7, R8.1, U2.34 (PD3)
/JBTDO: J6.10, R11.1, U2.30 (PD4)
/JBTMS: J6.9, R9.1, U2.31 (PD0)
/JBnTRS: J6.6, R12.1, U2.33 (PD2)
/OSC_IN: C7.1, U2.19 (OSC_IN), Y1.1
/OSC_IN32: C9.1, JP1.1 (A), U2.16 (PE6), Y2.1
/OSC_OUT: C12.1, U2.20 (OSC_OUT), Y1.3
/OSC_OUT32: C10.1, JP2.1 (A), U2.15 (PE7), Y2.2
/PA0: J2.16, U2.63 (PA0)
/PA1: J2.15, U2.62 (PA1)
/PA2: J2.14, U2.61 (PA2)
/PA3: J2.13, U2.60 (PA3)
/PA4: J2.12, U2.59 (PA4)
/PA5: J2.11, U2.58 (PA5)
/PA6: J2.10, U2.57 (PA6)
/PA7: J2.9, U2.56 (PA7)
/PB5: J2.3, U2.50 (PB5)
/PB6: J2.4, U2.51 (PB6)
/PB7: J2.5, U2.52 (PB7)
/PB8: J2.6, U2.53 (PB8)
/PB9: J2.7, U2.54 (PB9)
/PB10: J2.8, U2.55 (PB10)
/PC0: J5.1, U2.42 (PC0)
/PC1: J5.2, U2.41 (PC1)
/PC2: J5.3, R19.1, U2.40 (PC2)
/PD5: J5.4, R18.2, SW3.1, U2.35 (PD5)
/PD6: J5.5, U2.36 (PD6)
/PD7: J5.6, U2.29 (PD7)
/PE0: J5.7, U2.26 (PE0)
/PE1: J5.8, U2.25 (PE1)
/PE2: J5.9, U2.22 (PE2)
/PE3: J5.10, U2.21 (PE3)
/PE6: J5.11, JP1.2 (B)
/PE7: J5.12, JP2.2 (B)
/PF0: J5.16, U2.2 (PF0)
/PF1: J5.15, U2.3 (PF1)
/PF2: J5.14, U2.4 (PF2)
/PF3: J5.13, U2.5 (PF3)
/PF4_MODE0: J6.3, R15.1, SW2.2, U2.6 (PF4)
/PF5_MODE1: J6.4, R16.1, U2.7 (PF5)
/PF6_MODE2: J6.5, R17.1, U2.8 (PF6)
/USBDN: F1.1, J4.A7 (D-), J4.B7 (D-), U2.10 (DN)
/USBDP: F2.1, J4.A6 (D+), J4.B6 (D+), U2.9 (DP)
/WAKEUP: J3.5, R13.1, U2.17 (WAKEUP)
/nRESET: C4.1, J3.4, R14.1, U2.18 (~RESET)
GND: C1.2, C2.2, C3.2, C4.2, C5.2, C6.2, C7.2, C8.2, C9.2, C10.2, C11.2, C12.2, D2.1 (K), D4.1 (K), F1.2, F2.2, J1.4, J2.1, J3.1, J3.3, J4.A1 (GND), J4.A12 (GND), J4.B1 (GND), J4.B12 (GND), J4.S1 (SHIELD), J6.1, R1.2, R15.2, R16.2, R17.2, R21.2, R22.2, SW3.2, U1.1 (GND), U2.11 (GND), U2.23 (AGND1), U2.27 (AGND), U2.39 (GND), U2.49 (GND), U2.64 (GND), U2.65 (PAD), Y1.2, Y1.4
unnamed: D1.2 (A), U1.2 (VO)
unnamed: D2.2 (A), R2.2
unnamed: D3.2, SW2.1
unnamed: D4.2 (A), R19.2
unnamed: J4.A5 (CC1), R21.1
unnamed: J4.B5 (CC2), R22.1
unnamed: Q1.1 (G), R1.1, SW1.2
unnamed: R20.1, SW2.3
VUSB: C1.1, J4.A4 (VBUS), J4.A9 (VBUS), J4.B4 (VBUS), J4.B9 (VBUS), J6.2, U1.3 (VI)

Notes on the sheet:
USER LED
PWR RESET
USER SWITCH

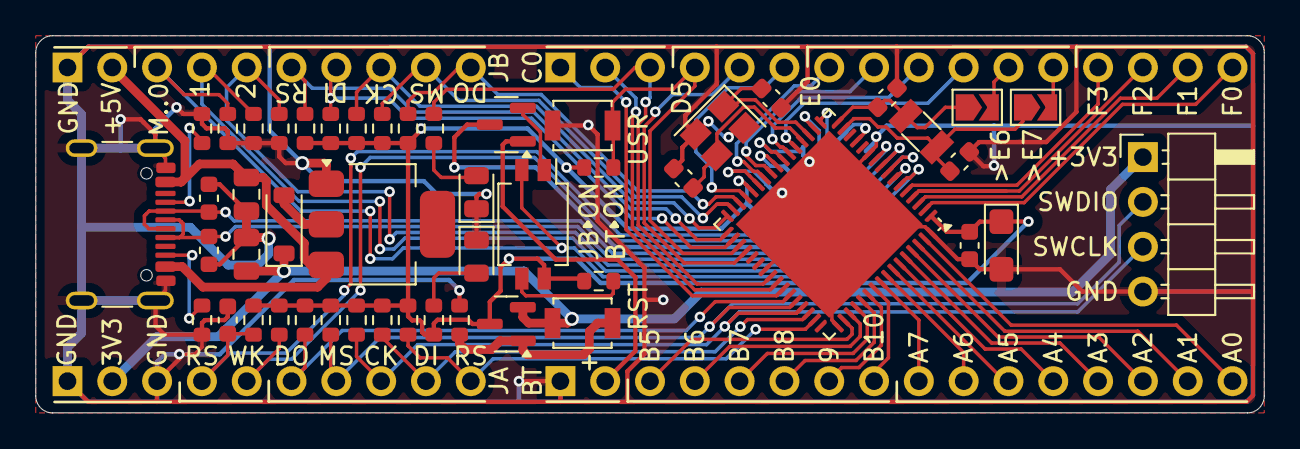
[picture p50: board MDR32-K1986BE92FI-DK.kicad_pcb from above]

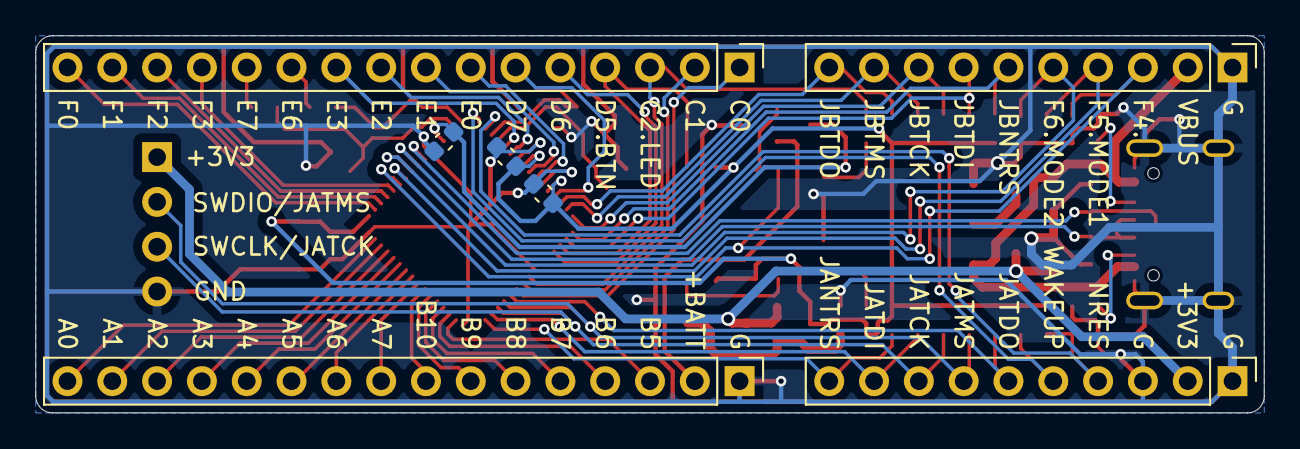
[picture p51: board MDR32-K1986BE92FI-DK.kicad_pcb from below]

Board: 2 copper layers, 69.6 x 21.4 mm, 56 parts (7 on the bottom side), 65 nets.
