mdr32/Boards/LDM-BB-K1986BE92QI-V1.03/kicad_src/LDM-BB-K1986BE92QI.kicad_pcb

## KiCad design LDM-BB-K1986BE92QI-V1.03/kicad_src/LDM-BB-K1986BE92QI.kicad_pcb (2022-06-08)

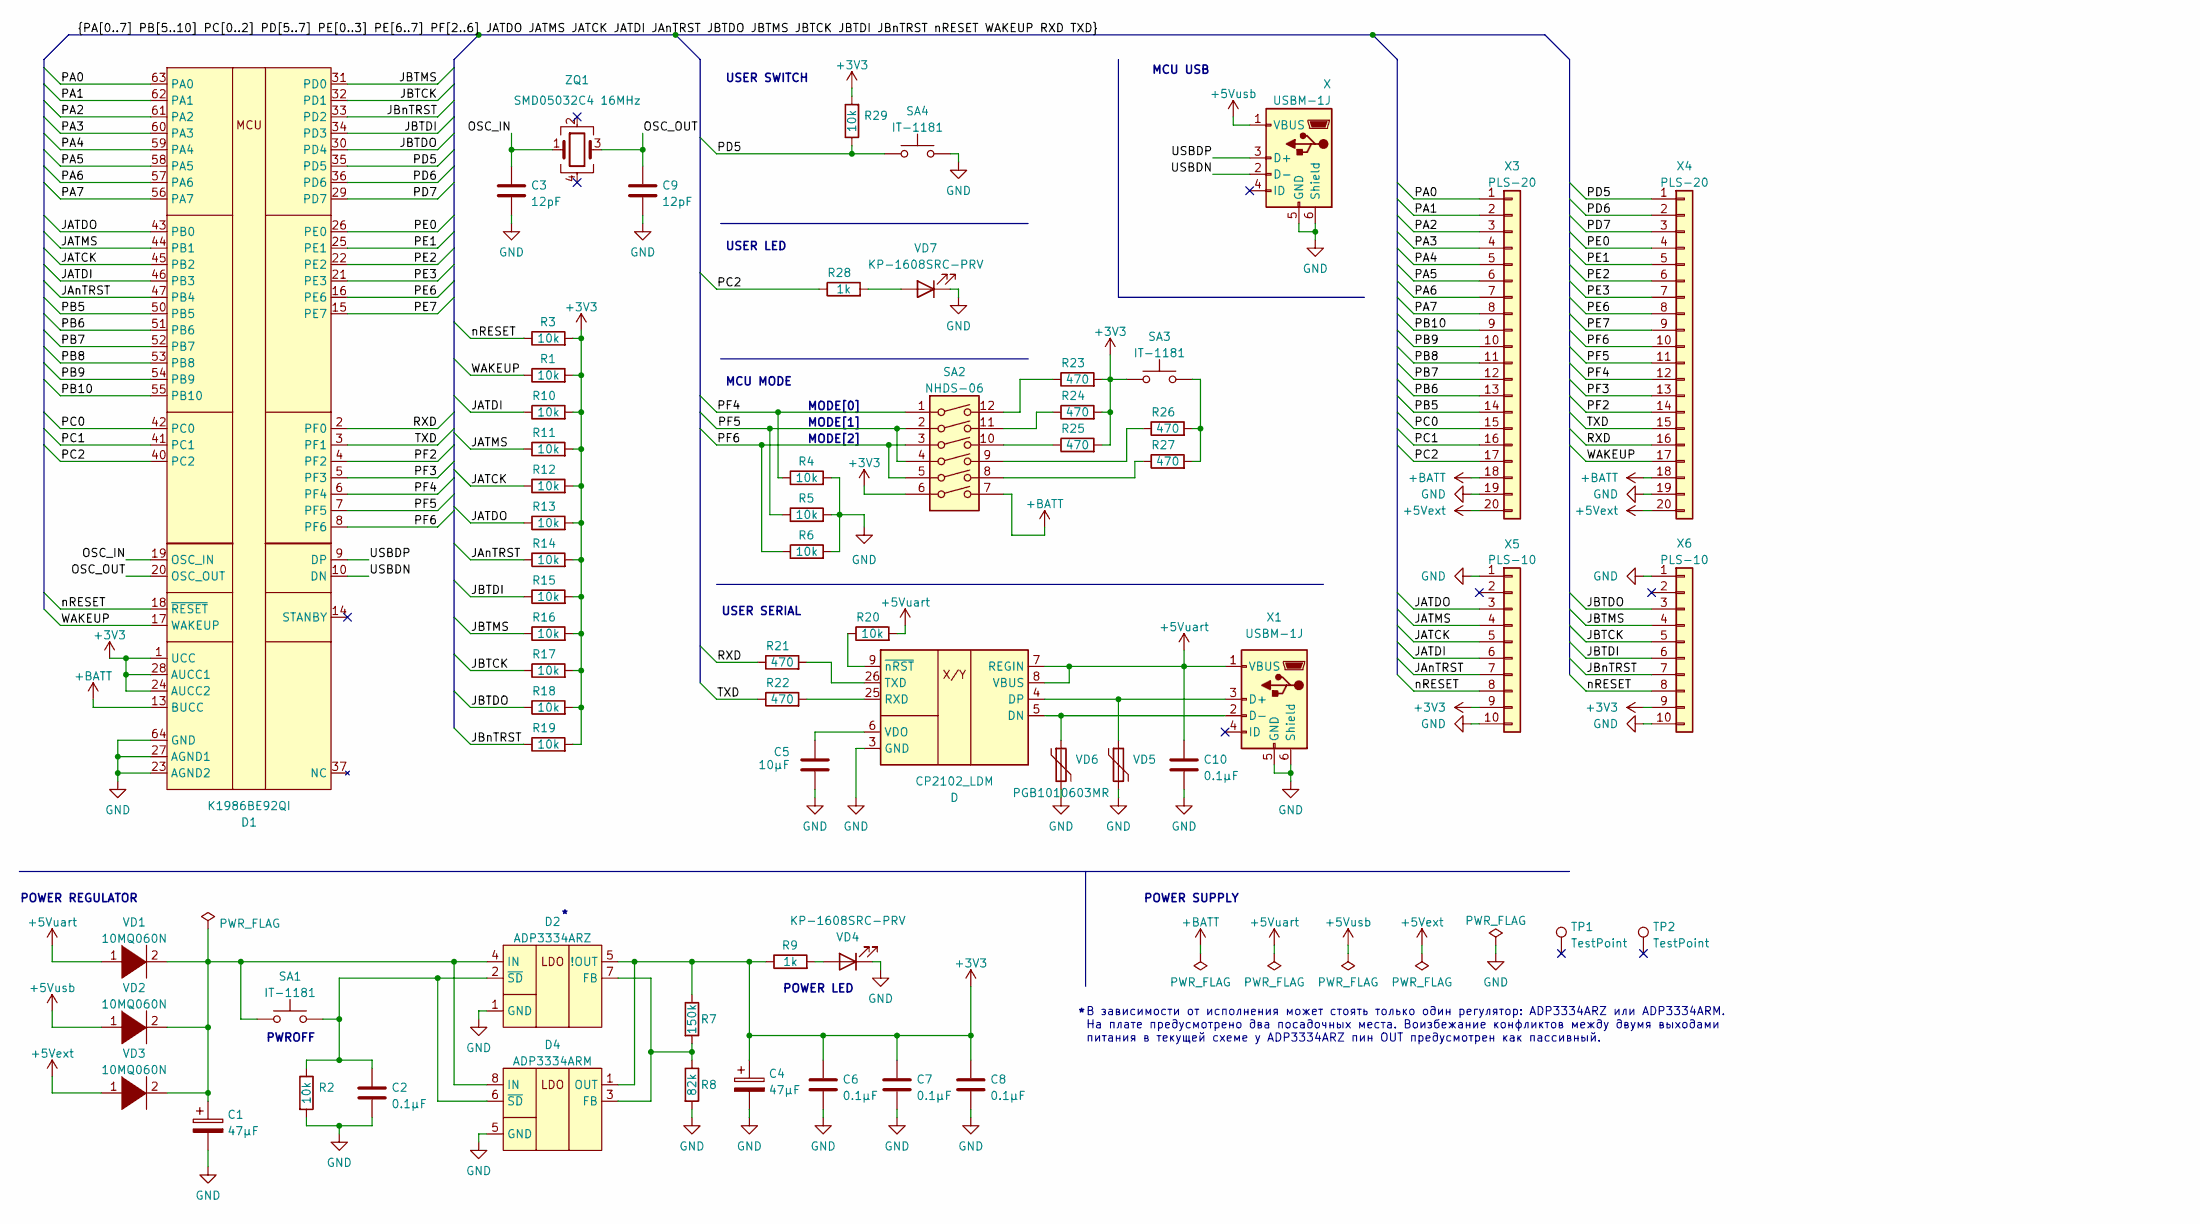
[picture p52: schematic LDM-BB-K1986BE92QI.kicad_sch]

Parts:
C1, C4: 47µF; CP_EIA-3528-21_Kemet-B
C2, C6, C7, C8, C10: 0.1µF; C_0603_1608Metric
C3, C9: 12pF; C_0603_1608Metric
C5: 10µF; C_1206_3216Metric
D: CP2102_LDM; QFN-28-1EP_5x5mm_P0.5mm_EP3.35x3.35mm
D1: K1986BE92QI; LQFP-64_10x10mm_P0.5mm
D2: ADP3334ARZ; SOIC-8_3.9x4.9mm_P1.27mm
D4: ADP3334ARM; MSOP-8_3x3mm_P0.65mm
R1, R2, R3, R4, R5, R6, R10, R11, R12, R13, R14, R15, R16, R17, R18, R19, R20, R29: 10k; R_0603_1608Metric
R7: 150k; R_0805_2012Metric
R8: 82k; R_0805_2012Metric
R9, R28: 1k; R_0603_1608Metric
R21, R22, R23, R24, R25, R26, R27: 470; R_0603_1608Metric
SA1, SA3, SA4: IT-1181; SW_SPST_CK_RS282G05A3
SA2: NHDS-06; SW_DIP_SPSTx06_Slide_Omron_A6H-6101_W6.15mm_P1.27mm
TP1, TP2: TestPoint; TestPoint_Pad_D1.0mm
VD1, VD2, VD3: 10MQ060N; DO-214AC
VD4, VD7: KP-1608SRC-PRV; LED_0603_1608Metric
VD5, VD6: PGB1010603MR; Fuse_0603_1608Metric
X, X1: USBM-1J; USB_Mini-B_Lumberg_2486_01_Horizontal
X3, X4: PLS-20; PinHeader_1x20_P2.54mm_Vertical
X5, X6: PLS-10; PinHeader_1x10_P2.54mm_Vertical
ZQ1: SMD05032C4 16MHz; Crystal_SMD_5032-4Pin_5.0x3.2mm

Connections:
+3V3: C4.1, C6.1, C7.1, C8.1, D1.1 (UCC), D1.12 (UCC), D1.24 (AUCC2), D1.28 (AUCC1), D1.38 (UCC), D1.48 (UCC), D2.5 (!OUT), D2.6 (!OUT), D4.1 (OUT), D4.2 (OUT), R1.2, R3.2, R7.1, R9.1, R10.2, R11.2, R12.2, R13.2, R14.2, R15.2, R16.2, R17.2, R18.2, R19.2, R23.2, R24.2, R25.2, R29.2, SA2.6, SA3.1, X5.9, X6.9
+5Vext: VD3.1 (K), X3.20, X4.20
+5Vuart: C10.1, D.7 (REGIN), D.8 (VBUS), R20.2, VD1.1 (K), X1.1 (VBUS)
+5Vusb: VD2.1 (K), X.1 (VBUS)
+BATT: D1.13 (BUCC), SA2.7, X3.18, X4.18
/JATCK: D1.45 (PB2), R12.1, X5.5
/JATDI: D1.46 (PB3), R10.1, X5.6
/JATDO: D1.43 (PB0), R13.1, X5.3
/JATMS: D1.44 (PB1), R11.1, X5.4
/JAnTRST: D1.47 (PB4), R14.1, X5.7
/JBTCK: D1.32 (PD1), R17.1, X6.5
/JBTDI: D1.34 (PD3), R15.1, X6.6
/JBTDO: D1.30 (PD4), R18.1, X6.3
/JBTMS: D1.31 (PD0), R16.1, X6.4
/JBnTRST: D1.33 (PD2), R19.1, X6.7
/OSC_IN: C3.1, D1.19 (OSC_IN), ZQ1.1
/OSC_OUT: C9.1, D1.20 (OSC_OUT), ZQ1.3
/PA0: D1.63 (PA0), X3.1
/PA1: D1.62 (PA1), X3.2
/PA2: D1.61 (PA2), X3.3
/PA3: D1.60 (PA3), X3.4
/PA4: D1.59 (PA4), X3.5
/PA5: D1.58 (PA5), X3.6
/PA6: D1.57 (PA6), X3.7
/PA7: D1.56 (PA7), X3.8
/PB5: D1.50 (PB5), X3.14
/PB6: D1.51 (PB6), X3.13
/PB7: D1.52 (PB7), X3.12
/PB8: D1.53 (PB8), X3.11
/PB9: D1.54 (PB9), X3.10
/PB10: D1.55 (PB10), X3.9
/PC0: D1.42 (PC0), X3.15
/PC1: D1.41 (PC1), X3.16
/PC2: D1.40 (PC2), R28.1, X3.17
/PD5: D1.35 (PD5), R29.1, SA4.1, X4.1
/PD6: D1.36 (PD6), X4.2
/PD7: D1.29 (PD7), X4.3
/PE0: D1.26 (PE0), X4.4
/PE1: D1.25 (PE1), X4.5
/PE2: D1.22 (PE2), X4.6
/PE3: D1.21 (PE3), X4.7
/PE6: D1.16 (PE6), X4.8
/PE7: D1.15 (PE7), X4.9
/PF2: D1.4 (PF2), X4.14
/PF3: D1.5 (PF3), X4.13
/PF4: D1.6 (PF4), R4.1, SA2.1, X4.12
/PF5: D1.7 (PF5), R5.1, SA2.2, SA2.4, X4.11
/PF6: D1.8 (PF6), R6.1, SA2.3, SA2.5, X4.10
/RXD: D1.2 (PF0), R21.1, X4.16
/TXD: D1.3 (PF1), R22.1, X4.15
/USBDN: D1.10 (DN), X.2 (D-)
/USBDP: D1.9 (DP), X.3 (D+)
/WAKEUP: D1.17 (WAKEUP), R1.1, X4.17
/nRESET: D1.18 (~RESET), R3.1, X5.8, X6.8
GND: C1.2, C2.2, C3.2, C4.2, C5.1, C6.2, C7.2, C8.2, C9.2, C10.2, D.3 (GND), D.29 (PAD), D1.11 (GND), D1.23 (AGND2), D1.27 (AGND1), D1.39 (GND), D1.49 (GND), D1.64 (GND), D2.1 (GND), D4.5 (GND), R2.2, R4.2, R5.2, R6.2, R8.2, SA4.2, VD4.1 (K), VD5.2, VD6.2, VD7.1 (K), X.5 (GND), X.6 (Shield), X1.5 (GND), X1.6 (Shield), X3.19, X4.19, X5.1, X5.10, X6.1, X6.10
IN: C1.1, D2.3 (IN), D2.4 (IN), D4.7 (IN), D4.8 (IN), SA1.1, VD1.2 (A), VD2.2 (A), VD3.2 (A)
unnamed: C2.1, D2.2 (~SD), D4.6 (~SD), R2.1, SA1.2
unnamed: C5.2, D.6 (VDO)
unnamed: D2.7 (FB), D4.3 (FB), R7.2, R8.1
unnamed: R9.2, VD4.2 (A)
unnamed: D.9 (~nRST), R20.1
unnamed: D.26 (TXD), R21.2
unnamed: D.25 (RXD), R22.2
unnamed: R23.1, SA2.12
unnamed: R24.1, SA2.11
unnamed: R25.1, SA2.10
unnamed: R26.1, SA2.9
unnamed: R26.2, R27.2, SA3.2
unnamed: R27.1, SA2.8
unnamed: R28.2, VD7.2 (A)
unnamed: D.4 (DP), VD5.1, X1.3 (D+)
unnamed: D.5 (DN), VD6.1, X1.2 (D-)

Notes on the sheet:
POWER REGULATOR
MODE[0]
MCU MODE
MODE[2]
POWER LED
USER LED
MODE[1]
USER SWITCH
POWER SUPPLY
MCU USB
В зависимости от исполнения может стоять только один регулятор: ADP3334ARZ или ADP3334ARM. На плате предусмотрено два посадочных места. Воизбежание конфликтов между двумя выходами питания в текущей схеме у ADP3334ARZ пин OUT предусмотрен как пассивный.
PWROFF
USER SERIAL

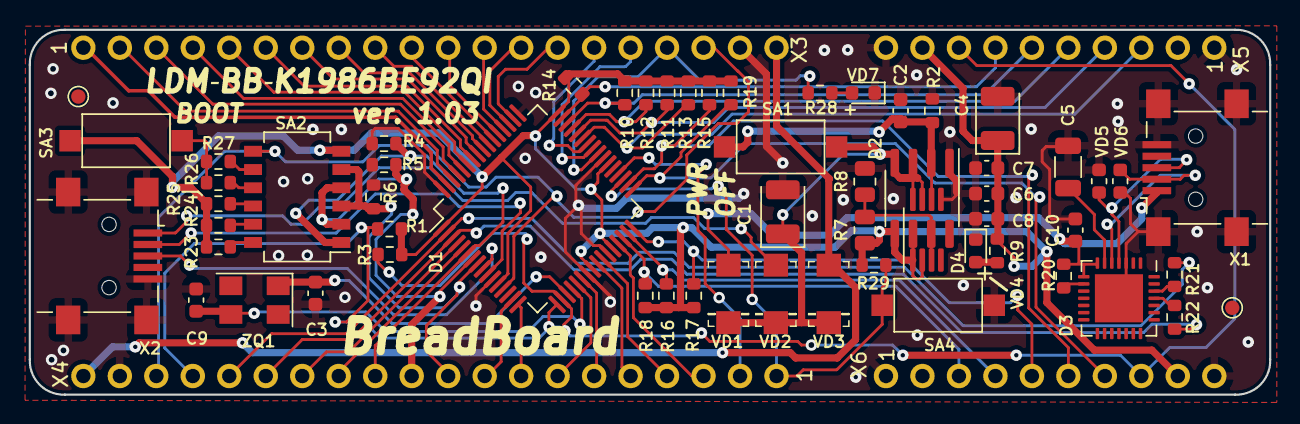
[picture p53: board LDM-BB-K1986BE92QI.kicad_pcb from above]

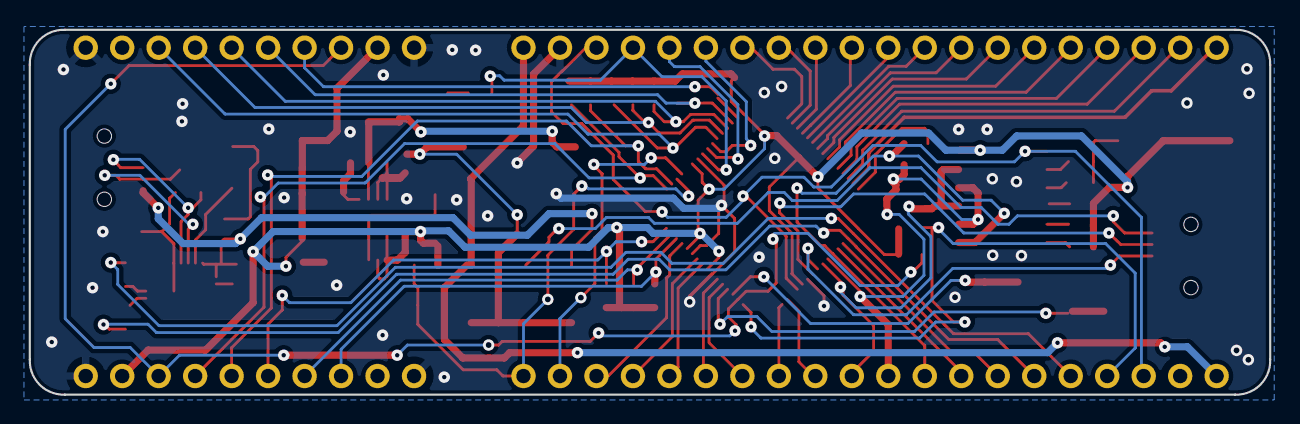
[picture p54: board LDM-BB-K1986BE92QI.kicad_pcb from below]

Board: 2 copper layers, 86.4 x 25.4 mm, 63 parts (4 on the bottom side), 72 nets.
