mdr32/Boards/(commit log)

2022-06-08 add board LDM-BB-K1986BE92QI-V1.03
    [5032_XTAL.step, CP_EIA-3528-21_Kemet-B.step, C_0603_1608Metric.step, C_1206_3216Metric.step, DO-214AC.step, Fuse_0603_1608Metric.step, LDM-BB-K1986BE92QI.kicad_pcb, LDM-BB-K1986BE92QI.kicad_sch]
2022-06-08 документация производителя и демо проект
    [5032_XTAL.step, CP_EIA-3528-21_Kemet-B.step, C_0603_1608Metric.step, C_1206_3216Metric.step, DO-214AC.step, Fuse_0603_1608Metric.step, LDM-BB-K1986BE92QI.kicad_pcb, LDM-BB-K1986BE92QI.kicad_sch]
2022-06-12 фикс игнор-листа
2022-06-13 + изображение схемы
2025-02-06 MDR32-K1986BE92FI-DK add board (#2)
    [CP_EIA-3216-18_Kemet-A.step, C_0603_1608Metric.step, C_0805_2012Metric.step, Crystal_SMD_3215-2Pin_3.2x1.5mm.step, Crystal_SMD_3225-4Pin_3.2x2.5mm.step, D_SOD-123.step, Fuse_0603_1608Metric.step, LED_0805_2012Metric.step]
2025-03-04 удаляем и запрещаем локальные файлы
2026-05-28 MDR32-K1986BE92FI-KeyBrain: gitignore файлов от новой версии kicad
2026-05-28 MDR32-K1986BE92FI-KeyBrain: добавляем стартовые файлы проекта
    [MDR32-K1986BE92FI-KeyBrain.kicad_pcb, MDR32-K1986BE92FI-KeyBrain.kicad_sch]
2026-06-02 MDR32-K1986BE92FI-KeyBrain: * выравниваем библиотеки * питание и USB в УГО
    [MDR32-K1986BE92FI-KeyBrain.kicad_sch]
2026-06-02 update schematic for KeyBrain
    [MDR32-K1986BE92FI-KeyBrain.kicad_sch]
2026-06-04 MDR32-K1986BE92FI-KeyBrain: более явные имена у пинов для SWD
    [MDR32-K1986BE92FI-KeyBrain.kicad_sch]
2026-06-04 MDR32-K1986BE92FI-KeyBrain: резистивная подтяжка сервисных пинов
    [MDR32-K1986BE92FI-KeyBrain.kicad_sch]
2026-06-04 MDR32-K1986BE92FI-KeyBrain: некоторые пины
    [MDR32-K1986BE92FI-KeyBrain.kicad_sch]
2026-06-04 MDR32-K1986BE92FI-KeyBrain: Пробуем вариант с портам A
    [MDR32-K1986BE92FI-KeyBrain.kicad_sch]
2026-06-06 MDR32-K1986BE92FI-KeyBrain: add diff pairs and comments on schematic
    [MDR32-K1986BE92FI-KeyBrain.kicad_sch]
2026-06-06 MDR32-K1986BE92FI-KeyBrain: add footprints and crystal
    [MDR32-K1986BE92FI-KeyBrain.kicad_sch]
2026-06-06 MDR32-K1986BE92FI-KeyBrain: update footprints, BOM & schematic
    [MDR32-K1986BE92FI-KeyBrain.kicad_sch]
2026-06-08 add components to pcb
    [MDR32-K1986BE92FI-KeyBrain.kicad_pcb, MDR32-K1986BE92FI-KeyBrain.kicad_sch]
2026-06-09 MDR32-K1986BE92FI-KeyBrain: rename SWD-pins
    [MDR32-K1986BE92FI-KeyBrain.kicad_sch]
2026-06-09 MDR32-K1986BE92FI-KeyBrain: mode select own pins
    [MDR32-K1986BE92FI-KeyBrain.kicad_sch]
2026-06-09 MDR32-K1986BE92FI-KeyBrain: less pcb options by only WAKEUP
    [MDR32-K1986BE92FI-KeyBrain.kicad_sch]
2026-06-09 MDR32-K1986BE92FI-KeyBrain: i2c pinout position
    [MDR32-K1986BE92FI-KeyBrain.kicad_sch]
2026-06-09 MDR32-K1986BE92FI-KeyBrain: release unconnected
    [MDR32-K1986BE92FI-KeyBrain.kicad_sch]
2026-06-09 MDR32-K1986BE92FI-KeyBrain: fix errors
    [MDR32-K1986BE92FI-KeyBrain.kicad_sch]
2026-06-09 MDR32-K1986BE92FI-KeyBrain: set jumper footprints
    [MDR32-K1986BE92FI-KeyBrain.kicad_sch]
2026-06-09 fix usb footprint
    [MDR32-K1986BE92FI-KeyBrain.kicad_pcb, MDR32-K1986BE92FI-KeyBrain.kicad_sch]
