mdr32/Boards/(notices)

Notices in the files:
LDM-BB-K1986BE92QI-V1.03/kicad_src/3dmodels/C_1206_3216Metric.step:
Copyright (C) 2017, kicad StepUp
This work is licensed under the [Creative Commons CC-BY-SA 4.0 License](https://creativecommons.org/licenses/by-sa/4.0/legalcode),
with the following exception:
To the extent that the creation of electronic designs that use 'Licensed Material' can be considered to be 'Adapted Material',
You are free to use the library data in your own projects without the obligation to share your project files under this or any other license agreement.
LDM-BB-K1986BE92QI-V1.03/kicad_src/3dmodels/LED_0603_1608Metric.step:
Copyright (C) 2018, kicad StepUp
MDR32-K1986BE92FI-DK/kicad_src/3dmodels/Crystal_SMD_3215-2Pin_3.2x1.5mm.step:
Copyright (C) 2024, KiCAD
This work is licensed under the
[Creative Commons CC-BY-SA 4.0 License](https://creativecommons.org/licenses/by-sa/4.0/legalcode),
project files under this or any other license agreement. However, if you wish to distribute
MDR32-K1986BE92FI-DK/kicad_src/3dmodels/Fuse_0603_1608Metric.step:
Copyright (C) 2020, kicad StepUp
LDM-BB-K1986BE92QI-V1.03/kicad_src/3dmodels/QFN-28-1EP_5x5mm_P0.5mm_EP3.35x3.35mm.step:
This program is free software: you can redistribute it and/or modify
it under the terms of the GNU General Public License as published by
the Free Software Foundation, either version 3 of the License, or
any later version.
itself might be covered by the GNU General Public License.
LDM-BB-K1986BE92QI-V1.03/kicad_src/3dmodels/SW_DIP_SPSTx06_Slide_Omron_A6H-6101_W6.15mm_P1.27mm.step:
Copyright (C) 2018, Terje Io
This work is licensed under the Creative Commons CC-BY-SA 4.0 License with the following exception:
To the extent that the creation of electronic designs that use 'Licensed Material'
https://creativecommons.org/licenses/by-sa/4.0/legalcode
